iraslav/dsd8-TriSync-DSD/DELIVERABLES_SUMMARY.md

# Timer/Counter Interrupt Add-On — Complete Deliverables Summary

You have been provided with **four comprehensive documents** covering every aspect of the interrupt system implementation.

---

## 📄 Document 1: START_HERE_Interrupt_Addon.md
**Purpose:** Entry point — read this first  
**Length:** ~3 pages  
**What It Contains:**
- High-level overview of what you're building
- Key facts (ports, sources, timeline)
- Three-step project breakdown
- File structure and port map
- Minimal assembly example
- Getting started checklist
- Common questions answered

**When to Read:** First thing — gets you oriented fast

**Key Section:** "Minimal Assembly Example" shows the entire pattern in 15 lines

---

## 📄 Document 2: Timer_Counter_Interrupt_Specification.md
**Purpose:** Complete technical reference  
**Length:** ~50 pages (comprehensive)  
**What It Contains:**
- Detailed hardware architecture (block diagrams)
- Complete register specifications (every bit documented)
- Verilog RTL implementation (~250 lines, ready to use)
- Unit testbench with assertions
- Software interrupt dispatcher in assembly
- Three test programs (with expected behavior)
- Design decisions and justifications
- Integration into dsd8_top.v

**When to Read:** While designing RTL and writing assembly  

**Key Sections:**
- "2. Hardware Architecture" — Block diagram and signals
- "5. Verilog Implementation" — Complete RTL code (copy-paste ready)
- "6. Integration into dsd8_top" — How to add to your design
- "7. Software: Interrupt Dispatcher" — Assembly patterns

---

## 📄 Document 3: Interrupt_Quick_Reference.md
**Purpose:** Quick lookup during implementation  
**Length:** ~6 pages  
**What It Contains:**
- Port map summary (all 16 ports at a glance)
- Register bit layouts (for quick reference)
- Minimal assembly program (complete, working example)
- Implementation checklist (track progress)
- Hardware verification strategy (quick sanity checks)
- Software implementation tips (best practices)
- Common pitfalls and solutions
- Performance expectations
- Testing strategy

**When to Read:** Keep this open while coding  

**Key Sections:**
- "Port Map Summary" — All you need to know about addresses
- "Minimal Assembly Program" — Paste-able, working code
- "Common Pitfalls & Solutions" — Troubleshooting table

---

## 📄 Document 4: Interrupt_Implementation_Roadmap.md
**Purpose:** Week-by-week implementation plan  
**Length:** ~20 pages  
**What It Contains:**
- Detailed breakdown for each week (13, 14, 15, 16)
- Day-by-day tasks with specific deliverables
- Complete code examples for every section
  - RTL module template
  - Dispatcher assembly
  - All test programs
  - Demo program
- Integration instructions (step-by-step)
- Documentation requirements for design report
- Oral defence preparation (talking points)
- Success criteria for each milestone
- Timeline summary and resource list

**When to Read:** At the start of each week  

**Key Sections:**
- "Week 13: RTL Design & Integration" — Complete RTL walkthrough
- "Week 14: Assembly & Verification" — All test programs provided
- "Week 15: Documentation & Demo" — What to document, what to show
- "Week 16: Final Demonstration & Oral Defence" — Defence talking points

---

## 🎯 How to Use These Documents

### Week 13 (RTL Design)

**Read:**
1. START_HERE (overview)
2. Interrupt_Implementation_Roadmap (Week 13 section)
3. Timer_Counter_Interrupt_Specification (Sections 2, 3, 5)

**Use:**
- Interrupt_Quick_Reference (port map)
- Interrupt_Implementation_Roadmap (RTL code examples)

**Create:**
- `interrupt_controller.v` (from spec + roadmap examples)
- `tb_interrupt_controller.v` (unit testbench)

**Verify:**
- Use Interrupt_Quick_Reference checklist

---

### Week 14 (Assembly & Testing)

**Read:**
1. Interrupt_Implementation_Roadmap (Week 14 section)
2. Timer_Counter_Interrupt_Specification (Sections 7, 8)

**Use:**
- START_HERE (dispatcher flow)
- Interrupt_Quick_Reference (port map reference)
- Interrupt_Implementation_Roadmap (assembly code examples)

**Create:**
- `interrupt_dispatcher.asm` (from roadmap)
- `test_interrupt_1.asm` (from roadmap)
- `test_interrupt_2.asm` (from roadmap)
- `test_interrupt_3.asm` (from roadmap)
- `demo_interrupt_blink.asm` (from spec/roadmap)

**Verify:**
- Use Interrupt_Quick_Reference (testing strategy)

---

### Week 15 (Documentation & Demo)

**Read:**
1. Interrupt_Implementation_Roadmap (Week 15 section)

**Reference:**
- Timer_Counter_Interrupt_Specification (design decisions section)
- START_HERE (common questions)

**Create:**
- Design report interrupt section
- System block diagram with interrupt controller
- Verification report with test results

---

### Week 16 (Demo & Defence)

**Read:**
1. Interrupt_Implementation_Roadmap (Week 16 section)

**Prepare:**
- Run demos (test programs from roadmap)
- Practice explanations (talking points in roadmap)

---

## 📋 Document Cross-Reference

### "How do I set up a timer?"
→ START_HERE: "Minimal Assembly Example"  
→ Interrupt_Quick_Reference: "Port Map Summary"  
→ Interrupt_Implementation_Roadmap: "Week 14: Day 1 Test Programs"

### "What are the exact register bit layouts?"
→ Interrupt_Quick_Reference: "Register Bit Layouts"  
→ Timer_Counter_Interrupt_Specification: "Section 3: Register Map"

### "How do I write the RTL?"
→ Interrupt_Implementation_Roadmap: "Week 13: Day 1-2 RTL Design"  
→ Timer_Counter_Interrupt_Specification: "Section 5: Verilog Implementation"

### "What should the dispatcher look like?"
→ START_HERE: "Minimal Assembly Example"  
→ Interrupt_Implementation_Roadmap: "Week 14: Day 1 Interrupt Dispatcher"  
→ Timer_Counter_Interrupt_Specification: "Section 7: Software: Interrupt Dispatcher"

### "What's wrong with my interrupt not firing?"
→ Interrupt_Quick_Reference: "Common Pitfalls & Solutions"  
→ Interrupt_Implementation_Roadmap: "Common Pitfalls & Solutions"

### "What should I explain in my oral defence?"
→ Interrupt_Implementation_Roadmap: "Week 16: Oral Defence Talking Points"  
→ Timer_Counter_Interrupt_Specification: "Section 13: Design Decisions & Justification"

---

## 📊 Document Relationship

```
START_HERE
    ↓ (provides overview)
    → Read first, gets you oriented

Interrupt_Implementation_Roadmap
    ↓ (detailed weekly plan)
    → Use this to track progress through weeks 13-16

Timer_Counter_Interrupt_Specification
    ↓ (comprehensive technical reference)
    → Consult while designing RTL, writing assembly

Interrupt_Quick_Reference
    ↓ (quick lookup)
    → Keep open in separate window while coding
```

---

## 🎓 Learning Outcomes

By following these documents you will:

✅ **Understand interrupt architectures** — Both hardware and software sides  
✅ **Build a real interrupt controller** — From register specifications to RTL  
✅ **Write interrupt handlers** — Assembly patterns that dispatch correctly  
✅ **Verify timing circuits** — Unit tests, integration tests, visual demo  
✅ **Document hardware design** — Professional design decisions and justifications  
✅ **Present technical work** — Confident oral defence with talking points prepared  

---

## ⏱️ Time Investment

| Document | Read Time | Reference Time |
|---|---|---|
| START_HERE | 15 min | — |
| Timer_Counter_Interrupt_Specification | 60 min | Ongoing |
| Interrupt_Quick_Reference | 10 min | Constant |
| Interrupt_Implementation_Roadmap | 30 min | Weekly |
| **Total** | **115 min** | **As needed** |

---

## 📝 Quick Navigation

**I need to understand what I'm building:**  
→ START_HERE

**I need to design the RTL:**  
→ Interrupt_Implementation_Roadmap (Week 13)  
→ Timer_Counter_Interrupt_Specification (Sections 2, 5)

**I need to write the dispatcher:**  
→ Interrupt_Implementation_Roadmap (Week 14, Day 1)  
→ START_HERE (Minimal Assembly Example)

**I forgot what port 0x58 does:**  
→ Interrupt_Quick_Reference (Port Map Summary)

**I'm troubleshooting a bug:**  
→ Interrupt_Quick_Reference (Common Pitfalls)

**I need to write the design report section:**  
→ Interrupt_Implementation_Roadmap (Week 15)  
→ Timer_Counter_Interrupt_Specification (Section 13)

**I need to prepare for the oral defence:**  
→ Interrupt_Implementation_Roadmap (Week 16, Oral Defence Talking Points)

---

## ✅ Document Checklist

Before you start:
- [ ] I have all four documents
- [ ] I understand what each document contains
- [ ] I know which document to consult for which task
- [ ] I've read START_HERE completely
- [ ] I have printed out or bookmarked Interrupt_Quick_Reference

---

## 🚀 You're Ready

Everything you need to build this interrupt system is in these four documents. They are:

1. **Self-contained** — Each document works independently
2. **Cross-referenced** — Links between them guide you to related info
3. **Progressive** — Start with START_HERE, move to detailed specs as needed
4. **Code-complete** — Full RTL, assembly, testbenches provided as examples

**Start with START_HERE. Then follow Interrupt_Implementation_Roadmap week by week. Keep Interrupt_Quick_Reference open always. Reference Timer_Counter_Interrupt_Specification when you need deep technical details.**

---

## 📞 Troubleshooting Guide

**"I'm confused where to start"**  
→ Read START_HERE cover to cover (15 min)

**"I need the exact RTL code"**  
→ Go to Timer_Counter_Interrupt_Specification, Section 5

**"I need a working assembly example"**  
→ Go to Interrupt_Implementation_Roadmap, Week 14, Day 1

**"My simulation isn't working"**  
→ Use Interrupt_Quick_Reference, "Common Pitfalls & Solutions"

**"I need to document this for the design report"**  
→ Go to Interrupt_Implementation_Roadmap, Week 15

**"I need to explain this in my oral defence"**  
→ Go to Interrupt_Implementation_Roadmap, Week 16, "Oral Defence Talking Points"

---

## Final Note

These documents represent **complete specification and implementation guidance** for the Timer/Counter Interrupt system. Everything — from the first RTL line to the final oral defence — is covered.

**You have a professional-quality specification for a real hardware system.**

Follow the roadmap. Execute week by week. Reference the documents as needed. You'll build something impressive.

**Good luck!** 🎯
