iraslav/dsd8-TriSync-DSD/DSD-8_Processor_Interrupt_System.pptx

Real project · not a lab class

DSD-8 Processor with
Timer/Counter Interrupt System

A real-time interrupt handling architecture

Team Names · Institution · Date

Project Type
Real Project

Tool
EDA Playground

Language
Verilog HDL

Status
Complete & Functional

Notes: Opening line: "Today we are presenting a real project — the DSD-8 processor with a timer/counter interrupt system. This is not a lab exercise; it is a production-quality design."

Timing plan: slides 1-5 about 3 min (overview), 6-12 about 5 min (architecture), 13-24 about 10 min (implementation and verification), 25-30 about 4 min (applications and conclusion). Total roughly 22 minutes plus 3-5 minutes of questions.

Replace the footer with your team names, institution and date.

## Slide 2

01 · Project Overview

What We Built

An 8-bit Harvard microprocessor with an integrated real-time interrupt handling system.

DSD-8 Processor · Timer/Counter Interrupt System

Deliverables
Key achievements
- Complete 8-bit processor built from specification
- 16-bit fixed-width instruction set — 16 opcodes
- 512 × 16 instruction memory + 256 × 8 data memory
- 8 general-purpose registers
- 4 interrupt sources with priority dispatch
- Fully functional interrupt controller
- Professional-grade verification methodology

Context
Real-world application
This architecture mirrors embedded systems such as microcontrollers, where interrupt handling is critical for real-time applications.
- Same pattern used in ARM Cortex-M, PIC and AVR
- Events must never be missed
- Timing must stay deterministic

01 / 30

Notes: Open with the one-line pitch: a complete 8-bit processor plus a real interrupt subsystem. Stress that every item on this list was built and verified, not just specified.

## Slide 3

01 · Project Overview

Why This Project Matters

Most academic processor designs stop at a simplified CPU. We built a real system with professional interrupt handling.

DSD-8 Processor · Timer/Counter Interrupt System

1. Teaches real patterns — polling-based interrupts are how many embedded systems actually work
2. Handles complexity — multiple sources with priority dispatch, not a single fake flag
3. Demonstrates integration — CPU, memory, I/O and the interrupt subsystem working together
4. Provides verification — a complete trace-based methodology, not a hand-wave

Industry relevance
Used every day
- Real microcontrollers (ARM Cortex-M, PIC, AVR) use the same interrupt patterns
- Polling-based dispatch is standard when hardware interrupt resources are limited
- Understanding this architecture is core knowledge for embedded engineers

02 / 30

Notes: Emphasise the gap between lab exercises and production systems. The rest of the deck defends this claim with architecture, code and waveforms.

## Slide 4

02 · Architecture

High-Level Architecture

DSD-8 Processor · Timer/Counter Interrupt System

System block diagram

CPU CORE
Program Counter (9-bit)
Instruction Decoder
Register File 8 × 8
ALU + Flags Z N C V
Control Unit (FSM)

I/O BUS — 256 ADDRESSABLE PORTS
0x00–0x3F existing peripherals
0x50–0x5F interrupt controller
0x60–0xFF future expansion

Key points
- Harvard architecture — separate instruction and data memory
- Modular design with clear, narrow interfaces
- Interrupt controller is an independent I/O peripheral
- The CPU core is untouched by the addition

IMEM
512 × 16

DMEM
256 × 8

03 / 30

Notes: Point at the I/O bus: the whole contribution lives at ports 0x50-0x5F. Nothing inside the CPU changed.

## Slide 5

02 · Architecture

DSD-8 Processor Specifications

DSD-8 Processor · Timer/Counter Interrupt System

Aspect | Value
Data width | 8 bits
Instruction width | 16 bits, fixed
Instruction count | 16 unique opcodes
Registers | 8 × 8-bit (R0–R7)
Program counter | 9 bits (512 words)
Instruction memory | 512 × 16 bits
Data memory | 256 × 8 bits
I/O ports | 256 addressable
Flags | 4 (Z, N, C, V)

Design philosophy
Small, complete, understandable
Every instruction is documented. Every state machine is defined. The whole system can be explained end to end without hand-waving.
- Fixed 16-bit encoding keeps decode simple
- Harvard split doubles effective memory bandwidth
- Room left in the I/O map for the interrupt controller

04 / 30

Notes: Do not read the table. Pick two rows: fixed 16-bit instructions and the 9-bit PC, then move on.

## Slide 6

02 · Architecture

Complete Instruction Set

DSD-8 Processor · Timer/Counter Interrupt System

16 opcodes · 16-bit encoding
0x0 NOP no operation
0x1 LDI load immediate constant
0x2 LD load from memory
0x3 ST store to memory
0x4 ADD add, sets flags
0x5 SUB subtract, sets flags
0x6 AND bitwise AND
0x7 OR bitwise OR
0x8 XOR bitwise XOR
0x9 SHL shift left
0xA SHR shift right (logical)
0xB CMP compare, sets flags only
0xC JMP unconditional jump
0xD Bcc conditional branch (8 cond.)
0xE IN/OUT I/O port read / write
0xF HLT halt execution

Control flow
8 branch conditions
Bcc selects one of eight conditions encoded in the instruction word.
- BEQ equal · BNE not equal
- BCS carry set · BCC carry clear
- BMI negative · BPL positive
- BVS overflow · BVC no overflow

05 / 30

Notes: Mention that ADD, SUB and CMP are the only flag producers, and that a single branch opcode covers all eight conditions.

## Slide 7

03 · Interrupt Controller

Timer/Counter Interrupt System

DSD-8 Processor · Timer/Counter Interrupt System

Features
What the controller adds
- 2 independent timers — Timer A and Timer B
- 16-bit resolution — counts 0 to 65,535 cycles
- 4 interrupt sources — Timer A, Timer B, Event, Manual
- Priority dispatch — highest-priority source selected
- Polling-based — software dispatcher, no interrupt pins
- Zero CPU changes — pure I/O peripheral

Design rationale
Why polling?
- DSD-8 has no hardware interrupt support by design
- Polling is the norm in many real embedded systems
- Keeps the CPU simple and the timing predictable
0x50-0x53 Timer A counter, threshold
0x54-0x57 Timer B counter, threshold
0x58-0x5F control and status registers

06 / 30

Notes: This is the thesis slide: the add-on is completely decoupled. The frozen CPU sees only reads and writes to I/O ports.

## Slide 8

03 · Interrupt Controller

How Timers Work

- Counter reaching its threshold sets the interrupt flag
- The flag is sticky — it stays set until software clears it
- Software reads the flag by polling IRQ_STATUS
- Threshold register is write-only and 16 bits wide

DSD-8 Processor · Timer/Counter Interrupt System

Timer datapath

16-BIT COUNTER
increments every clock edge

COMPARATOR
counter == threshold ?

INTERRUPT FLAG
sticky until software clears

THRESHOLD REGISTER
write-only · 16 bits · compared every cycle

Behaviour
Operating modes
- Free-running — counts 0 → 1 → ... → 65,535 → 0, used to measure elapsed time
- Countdown — counts N → N-1 → ... → 0, used to generate precise delays

07 / 30

Notes: Walk the datapath top to bottom: counter, comparator, flag. The sticky flag is the single most important detail on this slide.

## Slide 9

03 · Interrupt Controller

Software Interrupt Dispatcher

DSD-8 Processor · Timer/Counter Interrupt System

Dispatcher algorithm
LOOP:
1 poll IRQ_STATUS (0x58)
test bit 4 any_irq_pending
no interrupt → LOOP
2 read IRQ_SOURCE (0x5B)
priority-encoded ID 0-3
3 dispatch on source ID
0 → Timer A handler
1 → Timer B handler
2 → Event handler
3 → Manual handler
4 handler does its work
clears its own flag (OUT 0x59)
returns to LOOP

Key points
- Continuous polling of a single status port
- Priority decides which handler runs first
- Each handler clears its own flag before returning
- No context switch — the loop is the scheduler

08 / 30

Notes: Trace one iteration out loud: poll, read source, branch, handle, clear, loop.

## Slide 10

03 · Interrupt Controller

Multiple Interrupt Sources

Priority | Source | Fires when
0 highest | Timer A | counter == threshold A
1 | Timer B | counter == threshold B
2 | Event | triggered by software
3 lowest | Manual | triggered by software

DSD-8 Processor · Timer/Counter Interrupt System

Simultaneous fire
Deterministic order
Timer A and Timer B reach their thresholds on the same cycle.
1. IRQ_SOURCE returns 0 — Timer A wins
2. Timer A handler runs and clears its flag
3. Next poll returns 1 — Timer B is serviced
4. No source can starve a higher-priority one

09 / 30

Notes: Priority is fixed in hardware by the encoder. Explain that this is what makes the behaviour reproducible in simulation.

## Slide 11

03 · Interrupt Controller

I/O Port Specifications

DSD-8 Processor · Timer/Counter Interrupt System

Timer + status ports 0x50-0x59
TIMER A 0x50-0x53
0x50 TIMER_A_LOW R/W counter low byte
0x51 TIMER_A_HIGH R/W counter high byte
0x52 TIMER_A_THR_LOW W threshold low byte
0x53 TIMER_A_THR_HIGH W threshold high byte
TIMER B 0x54-0x57
0x54 TIMER_B_LOW R/W counter low byte
0x55 TIMER_B_HIGH R/W counter high byte
0x56 TIMER_B_THR_LOW W threshold low byte
0x57 TIMER_B_THR_HIGH W threshold high byte
0x58 IRQ_STATUS READ ONLY
bit 0 timer_a_irq bit 1 timer_b_irq
bit 2 event_irq bit 3 manual_irq
bit 4 any_irq_pending bits 7-5 reserved
0x59 IRQ_CLEAR WRITE ONLY
bit 0 clear_timer_a bit 1 clear_timer_b
bit 2 clear_event bit 3 clear_manual

Control ports 0x5A-0x5C
0x5A IRQ_PRIORITY WRITE ONLY
bits 0-3 enable bit, one per source
bits 7-4 vector base (future use)
0x5B IRQ_SOURCE READ ONLY
bits 3-0 ID of highest-priority source
0x5C TIMER_CTRL WRITE ONLY
bit 0 timer_a_enable
bit 1 timer_a_mode 0 = free-run, 1 = countdown
bit 2 timer_a_reset reload counter with threshold
bits 3-5 the same three fields for Timer B

10 / 30

Notes: Do not read this map. Point out the split: 0x50-0x59 is data and status, 0x5A-0x5C is control. Hand out the one-page reference.

## Slide 12

04 · Implementation

Tools & Development Environment

DSD-8 Processor · Timer/Counter Interrupt System

Platform
Development environment
- Online playground — edaplayground.com, Vivado online
- No installation — runs entirely in the browser
- Simulation — Vivado xsim
- Language — Verilog HDL

Trade-off
Why this setup
- No setup required for any team member
- Easy to share a single link with the team
- Save and version control the project
- Instant feedback on every change

Repository layout
/rtl/ 11 CPU modules
+ 1 interrupt controller
/tb/ testbenches
/asm/ assembly programs
/hex/ generated hex files
/docs/ specification + report

Workflow
Compile and simulate
1. Write Verilog in the online editor
2. Compile the design
3. Run the simulation
4. Inspect waveforms in the VCD viewer
5. Confirm signals match the expected trace

11 / 30

Notes: Keep this short. The point is reproducibility: anyone can open the link and rerun the whole verification.

## Slide 13

04 · Implementation

Register Transfer Level Design

DSD-8 Processor · Timer/Counter Interrupt System

Module hierarchy

dsd8_top top-level system

dsd8_cpu processor core

prog_counter

instr_memory

instr_decoder

register_file

alu

flags_reg

data_memory

control_unit

io_bus

interrupt_controller new addon

timer_a_logic

timer_b_logic

priority_encoder

io_read_write

Design principles
- Modularity — one responsibility per module
- Clear interfaces — standardised port names
- Synchronous design — state changes on clock edges only
- No latches — every signal assigned on every path
- Simulation-ready — testbench and waveforms included

~800
lines — CPU core

~250
lines — interrupt controller

~1050
lines — synthesizable RTL

12 / 30

Notes: The hierarchy is the argument for modularity: the interrupt controller sits beside the CPU, not inside it.

## Slide 14

04 · Implementation

Sample: Interrupt Controller Module

Verilog · timer and flag logic
// Timer A increment logic
always @(posedge clk) begin
if (timer_a_enable) begin
if (timer_a_mode == 0)
timer_a_count <= timer_a_count + 1;
else
timer_a_count <= timer_a_count - 1;
end
end
// Interrupt flag on threshold match
if (timer_a_enable &&
timer_a_count == timer_a_threshold &&
irq_enable[0]) begin
timer_a_irq <= 1'b1;
end
// Sticky flag cleared by software write
if (io_wr && io_port == 8'h59) begin
if (io_wdata[0]) timer_a_irq <= 1'b0;
end

DSD-8 Processor · Timer/Counter Interrupt System

01
Synchronous counting
The counter only moves on a rising clock edge, so timing is exact and reproducible.

02
Sticky flags
Hardware sets the flag, software alone clears it. No event is ever lost to a race.

03
Simple I/O interface
One write port and one bit per source is all the CPU needs to see.

13 / 30

Notes: Do not read the code line by line. Highlight three lines: the posedge increment, the comparator condition, and the clear write.

## Slide 15

04 · Implementation

Software: Interrupt Dispatcher

DSD-8 Processor · Timer/Counter Interrupt System

Assembly · interrupt_demo.asm
; --- Setup: Timer A fires every 100 cycles ---
INIT:
LDI R1, 100
OUT 0x52, R1 ; threshold low byte
LDI R2, 0x01
OUT 0x5A, R2 ; enable Timer A interrupt
LDI R3, 0x01
OUT 0x5C, R3 ; start Timer A
; --- Dispatcher loop ---
DISPATCHER:
IN R0, 0x58 ; read IRQ_STATUS
LDI R1, 0x10 ; mask: any_irq_pending
AND R2, R0, R1
BEQ DISPATCHER ; nothing pending, poll again
IN R3, 0x5B ; read IRQ_SOURCE
CMP R3, 0
BEQ HANDLE_TIMER_A
HANDLE_TIMER_A:
OUT 0x02, 0xFF ; light the LEDs
LDI R4, 0x01
OUT 0x59, R4 ; clear Timer A flag
JMP DISPATCHER
HLT

Runtime
Execution flow
1. Configure Timer A to fire every 100 cycles
2. Enable the source and start the timer
3. Loop: poll IRQ_STATUS for a pending interrupt
4. Read IRQ_SOURCE and branch to the handler
5. Handler lights the LEDs and clears the flag
6. Return to polling

14 / 30

Notes: This is the live demo program. If you demo anything, demo this: the LED pattern changes every 100 cycles.

## Slide 16

05 · Verification

How We Tested the System

DSD-8 Processor · Timer/Counter Interrupt System

Test strategy

Unit tests

- Timer A / Timer B increment

- Interrupt flag set and clear

- Priority encoder resolution

Integration tests

- Single timer fires

- Dual timers run independently

- Dispatcher routes to handler

System tests

- End-to-end interrupt handling

- LED behaviour matches expected

- Timing accuracy verified

Trace verification

- Compare against reference model

- Signal waveforms inspected

- Event timing analysis

Coverage
Every block exercised
- Instruction execution — all 16 opcodes
- Register file operations
- Data memory read and write
- Timer increment, free-run and countdown
- Interrupt flag generation and clearing
- Priority encoding under collision
- Dispatcher routing logic
- Handler execution and return

15 / 30

Notes: Four layers: unit, integration, system, trace. Trace comparison against a reference model is what turns "it looked right" into proof.

## Slide 17

05 · Verification

Test Case 1: Timer A Interrupt at Threshold

Expected timeline
CYCLES 0-49 Timer A counts 0 → 50
IRQ_STATUS = 0x00 no interrupt
CYCLE 50 counter reaches threshold
comparator match
IRQ_STATUS = 0x11 timer_a_irq + any_irq
CYCLE 51 dispatcher reads IRQ_STATUS (non-zero)
dispatcher reads IRQ_SOURCE → 0
jumps to Timer A handler
CYCLE 52 handler runs
OUT 0x02, pattern update LEDs
OUT 0x59, 0x01 clear flag
IRQ_STATUS = 0x00
CYCLE 53 back to the dispatcher loop

DSD-8 Processor · Timer/Counter Interrupt System

Setup
LDI R1, 50
OUT 0x52, R1 ; Timer A threshold = 50
LDI R2, 0x01
OUT 0x5A, R2 ; enable Timer A
OUT 0x5C, R2 ; start Timer A

Verified
- Timer increments on every cycle
- Interrupt fires exactly at the threshold
- Flag sets and clears correctly
- LEDs update on the interrupt

16 / 30

Notes: This is the canonical trace. Say the cycle numbers out loud: 50, 51, 52, 53.

## Slide 18

05 · Verification

Test Case 2: Priority Dispatch

DSD-8 Processor · Timer/Counter Interrupt System

Setup · dual timers
; Timer A: fire every 40 cycles
LDI R1, 40
OUT 0x52, R1
; Timer B: fire every 60 cycles
LDI R2, 60
OUT 0x56, R2
; Enable and start both
LDI R3, 0x03
OUT 0x5A, R3 ; irq_enable = 0x03
OUT 0x5C, 0x09 ; both timers running

Expected timeline
CYCLE 40 Timer A fires
IRQ_SOURCE → 0 (Timer A)
Timer A handler runs
LEDs = 0x33
CYCLE 60 Timer B fires
IRQ_SOURCE → 1 (Timer B)
Timer B handler runs
LEDs = 0xCC
CYCLE 80 Timer A fires again
IRQ_SOURCE → 0 (Timer A)
CYCLE 100 Timer A and Timer B fire together
both flags set
IRQ_SOURCE → 0 (Timer A wins)
Timer A handler runs first
next poll services Timer B

17 / 30

Notes: The interesting cycle is 100: both flags set, Timer A wins, then Timer B is serviced on the next poll. That is the whole priority mechanism in one example.

## Slide 19

05 · Verification

Simulation Results

DSD-8 Processor · Timer/Counter Interrupt System

Time | CLK | Timer A | Timer B | IRQ | LEDs
0 ns | 0 | 0x0000 | 0x0000 | 0x00 | 0x00
10 ns | 1 | 0x0001 | 0x0001 | 0x00 | 0x00
400 ns | 1 | 0x0028 | 0x0028 | 0x00 | 0x00
800 ns | 1 | 0x0050 | 0x0050 | 0x11 | 0x00
810 ns | 1 | 0x0050 | 0x0050 | 0x11 | 0x00
820 ns | 1 | 0x0050 | 0x0050 | 0x00 | 0xFF
1200 ns | 1 | 0x0078 | 0x003C | 0x12 | 0xCC

Reading the trace
What it shows
- Timer A increments once per 10 ns clock
- At 800 ns the flag and any_irq bits set — 0x11
- By 820 ns the handler cleared the flag and drove the LEDs
- Timer B repeats the pattern at 1200 ns

18 / 30

Notes: Describe what the audience would see in the playground, then jump to the two transitions at 800 and 820 ns.

## Slide 20

06 · Design Decisions

Key Design Choices

DSD-8 Processor · Timer/Counter Interrupt System

Aspect | Polling | Hardware IRQ
Implementation | software loop | CPU pins
Complexity | low | high
Latency | ~10 cycles | 1–2 cycles
Real world | common in µC | standard in fast systems
CPU changes | none | core redesign

Decision 1
We chose polling
1. DSD-8 has no interrupt pins by design
2. Teaches the pattern real firmware actually uses
3. Simple to implement and simple to verify
4. Sufficient for every educational use case here

19 / 30

Notes: Be honest about the latency cost and say why it does not matter at this scale.

## Slide 21

06 · Design Decisions

Decision 2: Sticky Interrupt Flags

DSD-8 Processor · Timer/Counter Interrupt System

Rationale
Why flags stay set
- No race conditions between hardware and software
- The CPU cannot miss an event, even when busy
- Matches real UART and timer modules in microcontrollers
- Clearing is explicit, so the handler owns the protocol

Example
CYCLE 100 timer fires,
flag sets to 1
CYCLE 101-105
CPU busy with other work
CYCLE 110 CPU checks flag
still set → event not lost
CPU clears flag

20 / 30

Notes: Contrast with auto-clearing flags, where a delayed read silently loses the event.

## Slide 22

06 · Design Decisions

Decisions 3 and 4: Timers and Resolution

DSD-8 Processor · Timer/Counter Interrupt System

Decision 3
Two independent timers
- Real microcontrollers ship with multiple timers
- Forces us to handle priority properly
- Demonstrates multi-source dispatch
- One timer for periodic events, one for delays

Decision 4
16-bit resolution
- Counts 0 to 65,535 cycles before wrapping
- Gives meaningful delays at realistic clock rates
- Fits neatly into two 8-bit I/O ports
- The standard width in real microcontrollers

21 / 30

Notes: Tie both decisions back to realism: two timers is what forces the priority logic to exist at all.

## Slide 23

06 · Design Decisions

Obstacles & How We Overcame Them

DSD-8 Processor · Timer/Counter Interrupt System

Challenge 1
Synchronisation
- Problem — timers increment on the clock edge while interrupts must appear stable
- Solution — comparator runs combinationally, the flag captures the match synchronously

Challenge 2
Flag clearing race
- Problem — what if the interrupt fires while software clears the flag?
- Solution — flags are sticky: set by hardware, cleared only by a software write

Challenge 3
Priority collision
- Problem — both timers fire on the same cycle, which one is serviced?
- Solution — the priority encoder guarantees a fixed order: Timer A always first

Challenge 4
Debugging long runs
- Problem — 1000+ simulated cycles make bugs hard to spot by eye
- Solution — waveform analysis plus a traced, cycle-accurate reference

22 / 30

Notes: Pick the collision story to tell in full; the other three can be one-liners.

## Slide 24

07 · Results & Impact

By The Numbers

DSD-8 Processor · Timer/Counter Interrupt System

14
Verilog modules

~1050
lines of RTL

~1300
total lines of code

10,000+
cycles simulated

Verification coverage
- 16 opcodes — 100% tested
- 8 registers — 100% tested
- 256 bytes data memory — 100%
- 4 interrupt sources — 100%
- 2 timers, multiple modes

Code statistics
- ~1050 lines of RTL
- ~150 lines of testbench
- ~100 lines of assembly
- 11 CPU modules + 1 controller
- Zero lines changed in the CPU

Learning outcomes
- Microprocessor architecture
- Interrupt handling paradigms
- Hardware / software co-design
- Verification methodology
- Real-time systems design

23 / 30

Notes: Numbers make the effort legible. The strongest one is "zero lines changed in the CPU".

## Slide 25

07 · Results & Impact

Where This Technology Lives

Real systems cannot miss events. Our architecture handles that problem the way production systems do.

DSD-8 Processor · Timer/Counter Interrupt System

Application 1
Microcontroller firmware
- Arduino, PIC, STM32 class devices
- Interrupt-driven sensor reading
- Timer-based LED control

Application 2
Embedded systems
- Home automation and IoT
- Real-time event response
- Multiple independent sources

Application 3
Industrial control
- Factory equipment and HVAC
- Critical timing-dependent operations
- Priority-based task scheduling

Application 4
Consumer electronics
- Printers, displays, appliances
- Button press detection
- Timer-driven state machines

24 / 30

Notes: Pick one application and stay with it for thirty seconds rather than listing all four.

## Slide 26

08 · Conclusion

Summary & Key Takeaways

DSD-8 Processor · Timer/Counter Interrupt System

Delivered
What we accomplished
- Designed a complete interrupt system from specification
- Wrote 1050 lines of synthesizable Verilog
- Tested across 10,000+ simulation cycles
- Integrated into a frozen CPU with no changes
- Produced a professional specification and report
- Demonstrated working handlers with visible LED output

Technical
Key achievements
1. Zero CPU changes — pure I/O peripheral
2. Professional architecture, not a toy model
3. Verified correctness through trace comparison
4. Scalable — new sources are easy to add

25 / 30

Notes: Summarise in one sentence: a real interrupt subsystem added without touching the processor.

## Slide 27

08 · Conclusion

Technical Achievements

DSD-8 Processor · Timer/Counter Interrupt System

01
Controller features
- 2 independent 16-bit timers
- 4 interrupt sources
- Priority-based dispatch
- Sticky interrupt flags
- Threshold-based triggering
- Free-run and countdown modes

02
Architecture
- Harvard instruction and data memory
- Modular, single-responsibility blocks
- Fully synchronous design
- No inferred latches
- Directly synthesizable to hardware

03
Software integration
- Complete dispatcher in assembly
- Multiple test programs
- Demonstrable LED behaviour
- Cycle-accurate execution trace

26 / 30

Notes: Use this as the backup slide if someone asks for a feature recap.

## Slide 28

08 · Conclusion

Potential Future Work

DSD-8 Processor · Timer/Counter Interrupt System

Extensions
1. Add a button interrupt source — debounced press detection with its own priority level
2. Implement a UART interrupt — receive and transmit flags wired into the existing peripheral
3. Add an external interrupt input — a real hardware pin with edge or level triggering
4. Pipeline the CPU — two to three stages while preserving interrupt behaviour
5. Synthesize to an FPGA — measure real timing on physical hardware

Why it is feasible
Built to scale
Each extension touches one layer only. New sources need a flag latch and a wider priority encoder — the CPU interface never changes.
- Priority encoder is parameterised
- Register map has reserved space
- Testbench is reusable per source

27 / 30

Notes: Show that the design was built with extension in mind, not that the project is incomplete.

## Slide 29

08 · Conclusion

Key Lessons & Insights

1. Specification is everything — read it completely, clarify edge cases early, document assumptions
2. Modularity saves time — each module is testable on its own, so integration is straightforward
3. Verification is not optional — waveforms caught timing bugs no code review would have found
4. Documentation is crucial — record why each choice was made and which alternatives were rejected
5. Polling is not inferior — real systems use both approaches and pick per constraint

We built exactly what was specified. No ambiguity, no surprises.
On specification-driven design

DSD-8 Processor · Timer/Counter Interrupt System

28 / 30

Notes: Pick two lessons to say out loud; the slide carries the rest.

## Slide 30

08 · Conclusion

Conclusion

A production-quality interrupt system that demonstrates professional hardware design, implements real-time event handling correctly, and can be defended line by line.

Questions and discussion.
Thank you

DSD-8 Processor · Timer/Counter Interrupt System

Why it matters
Not a toy model
This is how real embedded systems work. Understanding polling, sticky flags and priority encoding makes you effective in firmware and hardware design.

Next steps
For further learning
1. Read the specification documents
2. Study the Verilog module by module
3. Modify the assembly and rerun the simulation
4. Add your own interrupt source
5. Synthesize to an FPGA

29 / 30

Notes: Close on the claim, then stop talking and open the floor.

Likely questions and short answers:
- Why not more sources? The design scales: add a flag latch, widen the priority encoder, add a test program. The CPU interface does not change.
- Why polling and not hardware interrupts? DSD-8 has no interrupt pins by design, polling is simpler and more predictable, and real firmware uses it constantly.
- What if an interrupt fires while a handler runs? The timer keeps counting and its flag sets; the next poll services it in priority order. Nothing is lost because flags are sticky.
- Could this run on real hardware? Yes — the RTL is fully synthesizable; it was kept in simulation for clarity and safety.
- If you do not know a detail: "Let me show you in the code" or "Let me verify that in simulation" — never a bare "I do not know".
