iraslav/dsd8-TriSync-DSD/DSD8_Architecture_and_Toolchain_Guide.pptx

## DSD-8: How the Modules Fit Together

Block diagrams, the retire_ trace interface, the Python assembler, and how to write test programs that prove the processor works

PC

DEC

RF

ALU

FLAGS

DMEM

CTRL

IO

Digital System Design · DSD-8 processor project · class guide

Notes: This deck is a companion to the DSD-8 specification and the starter repository. It explains how the eleven RTL files connect, what every port (handle) is for, how the retire_ outputs turn your processor into something that can be graded automatically, how the Python assembler turns your assembly into a hex image, and how to write test programs systematically. Nothing here replaces the spec; where the spec and this deck disagree, the spec wins.

## What this guide covers

The architecture at a glance

numbers, hierarchy, files, instruction formats

1

slides 3–8

Module by module

every port (handle), where it connects, the rule that bites

2

slides 9–18

Wiring it together

system view, datapath, glue logic, control, branch, I/O, reset

3

slides 19–28

The retire_ interface

what retiring means, the ten trace outputs, timing, debugging

4

The Python assembler

language rules, two passes, encoders, .asm → .hex

5

Writing test programs

layers, rules, worked tests, random programs, bring-up order

6

slides 29–39

slides 40–47

slides 48–57

Notes: Parts 1 to 3 are the hardware: what exists and how it is wired. Part 4 is the bridge between your hardware and the grader. Parts 5 and 6 are the software side: how you produce programs and how you use them to find bugs.

## The architecture at a glance

Part 1

What DSD-8 is, how the files are organised, and the instruction formats every module is built around

1

Notes: Part 1: The architecture at a glance. What DSD-8 is, how the files are organised, and the instruction formats every module is built around.

## DSD-8 in eight numbers

8-bit

datapath

every register, ALU operand and memory byte is 8 bits

8

registers R0–R7

none hard-wired; R0 is an ordinary register

16

opcodes, 5 formats

16-bit instruction word, opcode always in [15:12]

512 × 16

instruction memory

9-bit PC, absolute branch targets 0x000–0x1FF

256 × 8

data memory

address comes from a register: LD rd,[rs1]

256

I/O ports

separate port space via IN / OUT with a ready handshake

4

flags Z N C V

set only by ADD SUB AND OR XOR SHL SHR CMP

1

trace line per instruction

emitted from retire_* — this is how you are graded

Notes: Keep these numbers in your head; they explain every port width you will see. 9 bits of PC because 512 instruction words. 8 bits of data address because 256 bytes. 3 bits of register address because 8 registers. 4 bits of opcode because 16 instructions. The last tile is the one this deck spends the most time on.

## Module hierarchy: board build and simulation build

On the FPGA board

In simulation (conformance grading)

dsd8_top

tb_dsd8
supplied harness

instr_memory
512×16 ROM

dsd8_cpu
the core

io_bus
ports + ready

instr_memory
#(IMAGE="Txx.hex")

dsd8_cpu
YOUR design

I/O side
io_bus + sim/peripherals.v

ownership

prog_counter

board pins
switches, buttons, leds, seg / an

retire_*

member A: fetch, decode

member B: regs, ALU

instr_decoder

trace writer
always @(posedge clk)
if (rst_n && retire) $fdisplay

member C: ctrl, mem, I/O

register_file

alu

shared

flags_reg

dut.trace

data_memory

Same core, two homes
tb_dsd8 instantiates dsd8_cpu directly. dsd8_top is only for the board demo, so a bug in dsd8_top can never cost conformance marks — and a port renamed in dsd8_cpu breaks the harness.

control_unit

Notes: Two trees, one core. On the left is the board build: dsd8_top wraps the core, the instruction ROM, the I/O bus and the board pins. On the right is the grading build: the supplied harness tb_dsd8 instantiates dsd8_cpu directly with an instruction memory loaded from one test's hex file, and writes a trace line whenever retire is high. instr_memory and io_bus are deliberately outside dsd8_cpu, so the core can be dropped into either home. Colours show module ownership from the starter repo comments: A owns PC, decoder and instruction memory; B owns register file, ALU and flags; C owns control unit, data memory and I/O bus. dsd8_cpu and dsd8_top are shared.

## The eleven RTL files

File | Owner | Kind | What it does | Spec
prog_counter.v | A | sequential | 9-bit PC: hold, increment (wraps) or load a branch target | §5.3
instr_memory.v | A | ROM, comb. read | 512 × 16 program store, filled from a .hex by $readmemh | §5.4
instr_decoder.v | A | combinational | slices the 16-bit word into opcode, register, immediate, address fields | §5.5
register_file.v | B | seq. write, comb. read | 8 × 8 registers, two read ports, one write port, all clear on reset | §5.6
alu.v | B | combinational | ADD SUB AND OR XOR SHL SHR CMP plus the Z N C V outputs | §5.7, §2.3
flags_reg.v | B | sequential | the architectural Z N C V, written only by flag-setting instructions | §5.8
data_memory.v | C | seq. write, comb. read | 256 × 8 RAM; no reset port, yet must read 0x00 before first write | §5.9
control_unit.v | C | FSM | sequences each instruction; drives every enable, select and retire | §6
io_bus.v | C | decode + handshake | port decode, LEDs / 7-seg registers, io_ready stall | §7
dsd8_cpu.v | shared | structural + glue | instantiates the seven core modules, muxes, retire_* outputs | §5.2
dsd8_top.v | shared | structural | board top: core + instruction ROM + I/O bus + pins | §5.1

Every port list is FROZEN: copy names and widths verbatim. Internals are yours.

Notes: Three kinds of file. Purely combinational modules (decoder, ALU) have no clock and recompute all the time. Sequential modules (PC, flags) change only at a rising clock edge and only when enabled. Memories mix the two: the write waits for an edge, the read is combinational. The two shared files are where integration happens, and dsd8_cpu is more than wires: it also holds the write-back multiplexer and a few gates of glue, which we look at in Part 3.

## Five instruction formats, one fixed field layout

R

ADD SUB AND OR XOR SHL SHR CMP

15

opcode

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
opcode

rd

0

imm8

M

LD ST

opcode

rd / data

rs1 = addr

000000

J

JMP Bcc

opcode

cond

addr9

P

IN OUT

opcode

rd / rs

dir

port

decoder outputs (always all of them):

opcode [15:12]

rd = cond [11:9]

rs1 [8:6]

rs2 [5:3]

io_dir [8]

addr9 [8:0]

imm8 = port [7:0]

Notes: Every format puts the opcode in bits 15 to 12, so decoding always starts the same way. The fields overlap on purpose: rd and cond are the same three bits, imm8 and port are the same eight bits, rs1 is the top of addr9. The decoder extracts every field from every word without looking at the opcode; the control unit decides which fields mean something. Two operand traps live here: in Format M the data register for ST sits in the rd position (bits 11:9), and in Format P the register for OUT also sits there. Reserved bits are written as zero by the assembler.

## Opcode map: what each instruction changes

Op | Instruction | Fmt | Operation | Reg write | DMEM write | Flags | Next PC
0 | NOP | – | nothing (0x0000) | – | – | – | PC+1
1 | LDI rd, imm8 | I | R[rd] ← imm8 | yes | – | – | PC+1
2 | LD rd, [rs1] | M | R[rd] ← DMEM[R[rs1]] | yes | – | – | PC+1
3 | ST [rs1], rs2 | M | DMEM[R[rs1]] ← R[rs2] (rs2 in bits 11:9) | – | yes | – | PC+1
4 | ADD rd, rs1, rs2 | R | R[rd] ← R[rs1] + R[rs2] | yes | – | Z N C V | PC+1
5 | SUB rd, rs1, rs2 | R | R[rd] ← R[rs1] − R[rs2] (C=1: no borrow) | yes | – | Z N C V | PC+1
6–8 | AND / OR / XOR | R | R[rd] ← R[rs1] op R[rs2] | yes | – | Z N, C=V=0 | PC+1
9 | SHL rd, rs1 | R | R[rd] ← R[rs1] << 1 | yes | – | Z N, C=b7, V=0 | PC+1
A | SHR rd, rs1 | R | R[rd] ← R[rs1] >> 1 (logical) | yes | – | Z N, C=b0, V=0 | PC+1
B | CMP rs1, rs2 | R | flags of R[rs1] − R[rs2], no register written | – | – | Z N C V | PC+1
C | JMP addr9 | J | PC ← addr9 | – | – | – | addr9
D | Bcc addr9 | J | if cond(flags): PC ← addr9 | – | – | – | addr9 / PC+1
E | IN rd, port | P | R[rd] ← io_rdata (dir = 0) | yes | – | – | PC+1
E | OUT port, rs | P | io_wdata ← R[rs] (dir = 1) | – | – | – | PC+1
F | HLT | – | stop; assert halted | – | – | – | holds

Notes: This table is the contract between the ISA and your control unit. Read it column by column: the Reg write column is exactly where rf_we must be 1, DMEM write is mem_we, Flags is flags_we. Two rows deserve a second look: CMP sets flags but writes no register, and ST takes its data from the register named in bits 11:9. Opcode 0xE is shared by IN and OUT; bit 8 (dir) tells them apart.

## Module by module

Part 2

Every port is a handle: who drives it, who listens, and the one rule that catches people

2

Notes: Part 2: Module by module. Every port is a handle: who drives it, who listens, and the one rule that catches people.

## prog_counter: where the next instruction comes from

Handle | Dir | Bits | Connects to | Purpose
clk, rst_n | in | 1 | system | sync. active-low reset: pc ← 0x000
pc_en | in | 1 | control_unit.pc_en | 1 = update PC at this edge; 0 = hold
pc_load | in | 1 | control_unit.pc_load | 1 = branch_addr; 0 = pc + 1 (wraps)
branch_addr | in | 9 | instr_decoder.addr9 | absolute JMP / Bcc target
pc | out | 9 | imem_addr, retire_pc | address of the executing instruction

prog_counter

sequential · 9-bit register

rst_n

pc_en

pc_load

branch_addr

clk

pc

9

9

always @(posedge clk)
if (!rst_n) pc <= 9'h000;
else if (pc_en) pc <= pc_load ? branch_addr
: pc + 9'd1;
// else: hold

What the frozen ports imply
There is no IR-load signal. Simplest scheme: keep PC on the current instruction for all of its cycles and pulse pc_en once, in its last cycle. Then imem_data is your instruction register and pc is retire_pc.

Classic bug
First instruction executed twice or skipped: check what pc_en does in the cycle reset is released.

Notes: The PC is the only state that decides which instruction runs. Its rule fits in four lines, shown in the code box; it is spec requirement R6–R7, not a design secret. The interesting part is the consequence of the frozen port lists: control_unit has no output to load an instruction register, so the cleanest design leaves the PC pointing at the executing instruction until the instruction finishes. The instruction memory read is combinational, so imem_data then stays valid for the whole instruction. If your team instead advances the PC early, you need your own IR and a copy of the old PC inside dsd8_cpu, both for decoding and for retire_pc.

## instr_memory: the program, loaded from a hex file

Handle | Dir | Bits | Connects to | Purpose
IMAGE | param | – | tb_dsd8 / dsd8_top | hex file read by $readmemh at time 0
clk | in | 1 | system | unused: the read is combinational
addr | in | 9 | imem_addr (= pc) | word address 0x000–0x1FF
data | out | 16 | imem_data | instruction word → decoder, retire_ir

instr_memory

512 × 16 ROM · #(IMAGE)

addr

9

clk

data

16

// T05.hex
// one word per line
0000
0000
F000

reg [15:0] mem [0:511];
initial $readmemh(IMAGE, mem);
assign data = mem[addr];

Words past the end of the image are X
$readmemh writes only as many words as the file holds; this module does not zero-fill the rest. A program that runs past its last line fetches X and the whole core goes X. End every program with HLT and keep branch targets inside it.

Notes: The instruction memory is read-only and outside dsd8_cpu. The harness instantiates it once per test with a different IMAGE parameter, which is why the hex file name never appears inside your core. The supplied module reads combinationally, so the word for address pc is available in the same cycle. Section 5.4 allows a registered read too, but then your control unit must budget the extra cycle. Note the X hazard: unlike data memory, nothing initialises the unused words.

## instr_decoder: slicing the word, never interpreting it

Output | Field | Width | Connects to | Purpose
opcode | [15:12] | 4 | control_unit, alu.op, glue | selects the instruction
rd | [11:9] | 3 | register_file.wa, ra2 mux | destination; ST / OUT data reg
rs1 | [8:6] | 3 | register_file.ra1 | first source; LD / ST address
rs2 | [5:3] | 3 | ra2 mux | second source (R format)
imm8 | [7:0] | 8 | write-back mux, input 2 | LDI constant
addr9 | [8:0] | 9 | prog_counter.branch_addr | JMP / Bcc target
cond | [11:9] | 3 | control_unit.cond | branch condition
port | [7:0] | 8 | dsd8_cpu.io_port | I/O port number
io_dir | [8] | 1 | IN/OUT glue in dsd8_cpu | 0 = IN, 1 = OUT

instr_decoder

combinational

rd

rs1

rs2

imm8

addr9

cond

port

io_dir

16

instr

opcode

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
This module never looks at opcode
Nine plain bit slices, no case statement. Overlaps are deliberate: rd = cond, imm8 = port, rs1 sits inside addr9. Choosing which field matters is the control unit's job.

Bit positions: spec Appendix A, and the comments in the stub itself.

Notes: The decoder is the simplest module in the design and the one whose bugs are most expensive, because a wrong slice looks like an execution bug. Check it against the worked encoding table in the spec (11 encodings) before running anything. Every handle except instr is an output, so the table lists bit positions instead of a direction. Notice where each field goes: rd goes to two places (write address and the ra2 multiplexer) because of the ST and OUT operand order.

## register_file: two reads, one write, eight registers

Handle | Dir | Bits | Connects to | Purpose
ra1 | in | 3 | decoder.rs1 | selects rd1
ra2 | in | 3 | ra2 mux: rs2, or rd for ST / OUT | selects rd2
rd1 | out | 8 | alu.a, data_memory.addr | R[ra1], combinational
rd2 | out | 8 | alu.b, dmem wdata, io_wdata | R[ra2], combinational
we | in | 1 | control_unit.rf_we (qualified) | write at this edge
wa | in | 3 | decoder.rd | register written
wd | in | 8 | write-back mux output | value written

register_file

seq. write · comb. read

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
rst_n

rd2

3

3

8

R14: same-cycle read returns the OLD value
A write and a read of the same register in one cycle: the read ports show the old contents; the new value appears from the next cycle. Do not add write-through forwarding — the reference does not have it.

Why ra2 needs a mux
ST [rs1], rs2 and OUT port, rs keep their data register in bits 11:9 (the rd field). So port 2 reads rs2 for R-format, rd for ST and OUT.

Notes: Two read ports so that an R-format instruction can read both operands in one cycle. rd1 always carries R[rs1], which is both the ALU's first operand and the data-memory address. rd2 carries the second operand, which for ST and OUT must be the register in the rd field: that is the reason for the small multiplexer on ra2, which lives in dsd8_cpu. Reset clears all eight registers; R0 is not special.

## alu: results and flags, from the opcode directly

Handle | Dir | Bits | Connects to | Purpose
a | in | 8 | register_file.rd1 | R[rs1]
b | in | 8 | register_file.rd2 | R[rs2]
op | in | 4 | decoder.opcode | 0x4 ADD … 0xB CMP (R15)
result | out | 8 | write-back mux, input 0 | the 8-bit result
flag_z…v | out | 1 | flags_reg.flags_in, retire | {Z,N,C,V} after the op

alu

combinational

flag_c

flag_v

8

8

a

result

8

4

b

op

flag_z

flag_n

Op | Z | N | C | V
ADD | result = 0 | result[7] | carry out of bit 7 | signed overflow
SUB, CMP | result = 0 | result[7] | 1 = no borrow (a ≥ b unsigned) | signed overflow
AND OR XOR | result = 0 | result[7] | 0 | 0
SHL | result = 0 | result[7] | old a[7] | 0
SHR (logical) | result = 0 | result[7] | old a[0] | 0

The bug this design reliably produces
C after SUB / CMP means NO borrow (compute a + ~b + 1 and take the carry). BCS = unsigned ≥. SHR shifts a 0 into bit 7: 0x80 >> 1 = 0x40.

Notes: The ALU takes the instruction opcode directly as its operation select, so there is no separate ALU-control encoding. CMP computes exactly what SUB computes; the difference is that the control unit does not write the result. The flag table is the whole truth: copy it into your testbench's reference model independently, and the spec requires a constrained-random self-checking testbench for this module. For opcodes that are not ALU operations, the outputs are don't-care, but give the case statement a default so nothing is inferred as a latch.

## flags_reg: architectural state with a narrow write enable

Handle | Dir | Bits | Connects to | Purpose
flags_we | in | 1 | control_unit.flags_we | 1 only for the 8 flag-setting instructions
flags_in | in | 4 | {flag_z, flag_n, flag_c, flag_v} | new flags from the ALU
flags_out | out | 4 | control_unit.flags, retire_flags | {Z,N,C,V}: bit 3 = Z … bit 0 = V

flags_reg

sequential · 4-bit register

rst_n

flags_we

flags_in

clk

flags_out

4

4

Z

bit 3

N

bit 2

C

bit 1

V

bit 0

Same order everywhere: flags_in, flags_out, control_unit.flags, retire_flags, and trace field 10.

Reset
Z = N = C = V = 0 after reset (R6). The stub already does this; you add only the flags_we write.

LD, LDI, IN do NOT set flags
Only ADD SUB AND OR XOR SHL SHR CMP write the flags. Branching on a value you just loaded needs a CMP first — a deliberate decision in the spec.

Notes: flags_reg is four flip-flops, but it is architectural state: programs see it through branches and the grader sees it in every trace line. The write enable must be exactly the eight flag-setting instructions. A common integration bug is to write the flags on every ALU-looking cycle, including LD, which corrupts a CMP result that a later branch depends on.

## data_memory: 256 bytes that must start at zero

Handle | Dir | Bits | Connects to | Purpose
addr | in | 8 | register_file.rd1 (R[rs1]) | byte address for LD and ST
we | in | 1 | control_unit.mem_we | write wdata at this edge (ST only)
wdata | in | 8 | register_file.rd2 (R[rd]) | byte to store
rdata | out | 8 | write-back mux, input 1 | mem[addr], combinational, for LD

data_memory

seq. write · comb. read

addr

we

wdata

8

clk

rdata

8

8

No rst_n port — yet R16 says every byte reads 0x00 after reset
Two legitimate answers (record your choice in the design report):
(a) initialise the array to zero in an initial block — every simulator, and FPGA block RAM that honours init values;
(b) let the control unit write 0x00 to all 256 addresses through the normal ports before the first fetch.
Test T09 reads a never-written address on purpose.

Address comes from a register, not from the instruction
LD R5, [R3] reads DMEM[R[3]] — the contents of R3, not address 3.

Notes: Data memory has the same shape as the register file: synchronous write, combinational read, so a load completes in the cycle its address is valid. It is the only stateful module without a reset port, and the stub tells you to decide how the zero-at-reset requirement is met. Both answers are acceptable; what matters is that you can explain yours at the oral defence. Address and write data both come from the register file, so no ALU is involved in address calculation: DSD-8 has no indexed addressing.

## control_unit: status in, enables and selects out

Handle | Dir | Bits | Connects to | Purpose
opcode, cond | in | 4, 3 | instr_decoder | which instruction; which branch test
flags | in | 4 | flags_reg.flags_out | Z N C V for the branch decision
io_ready | in | 1 | io_bus.io_ready | 0 = stay in the I/O state (stall)
pc_en, pc_load | out | 1 | prog_counter | advance / take the branch target
rf_we | out | 1 | register_file.we | commit wd into R[rd]
mem_we | out | 1 | data_memory.we | commit the ST byte
flags_we | out | 1 | flags_reg.flags_we | commit the ALU flags
wb_sel | out | 2 | write-back mux | 0 ALU · 1 DMEM · 2 imm8 · 3 io_rdata
io_rd, io_wr | out | 1 | io_bus (via glue) | request, held until io_ready
halted, retire | out | 1 | dsd8_cpu outputs | after HLT; one pulse per instruction

control_unit

FSM · your microarchitecture

flags_we

wb_sel

halted

retire

clk

rst_n

pc_en

pc_load

4

3

opcode

rf_we

4

cond

flags

mem_we

io_rd

io_ready

io_wr

2

Outputs are 'output reg'
Decode them from the state in an always @(*) block (Lecture 4, process 3). The stub's clocked block is only a latch-free placeholder: clocked outputs arrive one cycle late.

No io_dir input
The frozen ports cannot tell IN from OUT. Qualify io_rd, io_wr and rf_we with the decoder's io_dir inside dsd8_cpu (slide 22).

Notes: The control unit is the one module whose structure the spec leaves to you: single-cycle, multi-cycle (recommended) or pipelined. Its interface is fixed, though, and the interface already tells you a lot. Inputs are status: what instruction, which condition, what the flags say, whether the peripheral is ready. Outputs are enables (things that commit state at the next edge), selects (wb_sel), and two status outputs, halted and retire. Two consequences of the frozen ports are worth discussing with your team early: the outputs are declared reg but should normally be decoded combinationally from the state, and IN versus OUT has to be resolved outside this module because io_dir is not an input. These are interface facts, not a finished FSM: the state diagram and timing are yours to design and defend.

## io_bus: port decode and the ready handshake

Port | Name | Access | Function
0x00 | SWITCHES | read | eight slide switches
0x01 | BUTTONS | read | {3'b000, btnU, btnD, btnL, btnR, btnC}
0x02 | LEDS | write | eight LEDs, value latched
0x10 / 0x11 | SEG_VALUE / SEG_ENABLE | write | 7-seg value (hex) / digit enables
0x20–0x22 | UART_TX / RX / STATUS | w / r / r | status: bit 0 tx_busy, bit 1 rx_valid
0x30 / 0x31 | TIMER_COUNT / CTRL | r / w | free-running count / enable, clear
0x40 | SLOW_ECHO | r / w | echoes last write after 0–7 stall cycles
other | unmapped | – | read 0x00, write discarded, never stalls

CPU side
(frozen)

io_bus

decode + handshake

io_port

switches

io_wdata

buttons

io_rd

leds

io_wr

seg_value

io_rdata

seg_enable

io_ready

periph_*

board side
(adjustable)

R19–R21: the handshake
Request (io_rd / io_wr) stays high and port, data stay stable until io_ready = 1; no architectural state may change while waiting. No port may hold io_ready low forever. The stub ties io_ready = 0: a CPU wired to it hangs on the first IN/OUT.

Ports 0x00–0x3F (and 0x40) are reserved by the spec; 0x41–0xFF are free for extensions.

periph_* → sim/peripherals.v (UART, timer, SLOW_ECHO)

Notes: io_bus sits outside dsd8_cpu. Its CPU side is frozen by section 7.1; its board side in the stub is a starting design you may adjust, because no external testbench binds to it. Two rules from the port map matter for conformance: unmapped ports read 0x00 and ignore writes, and SLOW_ECHO at 0x40 is the test peripheral that holds io_ready low for a random 0 to 7 cycles, so it is the one place your stall logic is exercised. The stub deliberately ties io_ready low, so the first IN or OUT hangs until you implement the decode.

## Wiring it together

Part 3

From eleven separate files to one processor: the system view, the datapath, the glue, the control signals and the timing rules

3

Notes: Part 3: Wiring it together. From eleven separate files to one processor: the system view, the datapath, the glue, the control signals and the timing rules.

## System view: the core and its two neighbours

dsd8_cpu

inside view: next slide

io_port[7:0]

io_bus
decode ports
hold io_ready low
to stall

switches[7:0]

instr_memory
512 × 16
$readmemh(IMAGE)

imem_addr[8:0]

prog_counter

instr_decoder

io_wdata[7:0]

io_rd

buttons[4:0]

imem_data[15:0]

register_file

flags_reg

alu

data_memory

io_wr

leds[7:0]

control_unit

glue: muxes, retire

io_rdata[7:0]

io_ready

seg_*

7-seg driver
in dsd8_top

Not drawn
clk and rst_n go to every sequential module. rst_n is synchronous and active-low everywhere.

periph_*

seg, an

peripherals
UART · timer · SLOW_ECHO

→ halted LED / output

Frozen boundary
imem_*, io_* and retire_* are the only way in or out of the core.

halted

retire, retire_*

tb_dsd8 trace writer → dut.trace
simulation only; on the board these are unconnected

Notes: This is the system one level above the core. The core talks to exactly two things: the instruction memory, through a 9-bit address and a 16-bit word, and the I/O bus, through six signals. Everything else leaves through the status and trace outputs: halted, retire and the nine retire_ buses. On the board, the I/O bus connects to switches, buttons, LEDs and the seven-segment driver; in simulation the trace writer in tb_dsd8 listens to retire. Because all of this is frozen, two teams' cores are interchangeable in the harness, which is what makes conformance grading objective.

## Inside dsd8_cpu: the datapath

out: pc_en pc_load rf_we mem_we flags_we
wb_sel io_rd io_wr halted retire

data wire

control net (control_unit)

glue logic in dsd8_cpu

junction: wires connect

gap: crossing, no connection

rf_we

control_unit

sel

opcode

cond

imm8

flags

io_ready

instr_
decoder

register_
file

rf_we

rd1

op ← opcode

ALU

wb_sel

to / from io_bus
io_port ← decoder.port
io_wdata ← rd2 (= R[rd])
io_rd, io_wr ← control, qualified by io_dir
io_rdata → WB mux input 3
io_ready → control_unit
retire_* taps: slide 33

pc_en, pc_load

PC
prog_
counter

instr_
memory
outside the core

imem_addr / imem_data

rs1

rs2

ra1

rd1

result

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
flags_reg

Z N C V

→ flags

port → io_port

io_dir → glue

io_wdata

flags_we

io_rdata

3

data_
memory

addr

rdata

1

addr9 → branch_addr

wd: write-back data

mem_we

Notes: Read the datapath left to right. The PC addresses the instruction memory, which sits outside the core; the word comes back as imem_data and the decoder slices it. rs1 always drives read port 1. Read port 2 is driven by a small multiplexer: rs2 for R-format instructions, rd for ST and OUT, because those keep their data register in bits 11:9. rd1 feeds the ALU's first operand and the data-memory address; rd2 feeds the ALU's second operand, the data-memory write data and io_wdata. The write-back multiplexer chooses what goes into R[rd]: 0 ALU result, 1 memory data, 2 the immediate, 3 io_rdata; its output loops back along the bottom into wd. addr9 loops back along the bottom-left into the PC. Control nets are drawn as red tags instead of wires to keep the picture readable; every tag names the control_unit output that drives that input. The gap on rd2 where rd1 passes down to data memory is a crossing, not a connection.

## The glue: logic that lives in dsd8_cpu, not in a module

1 · Write-back multiplexer

selects wd for the register file

case (wb_sel)
2'd0: wd = alu_result;
2'd1: wd = dmem_rdata;
2'd2: wd = imm8;
2'd3: wd = io_rdata;
endcase

2 · Read-port-2 select

ST and OUT read the rd field

assign ra2 = (opcode == 4'h3 ||
opcode == 4'hE)
? rd : rs2;

3 · IN / OUT qualification

control_unit cannot see io_dir

// one possible scheme:
assign io_rd = cu_io_rd & ~io_dir;
assign io_wr = cu_io_wr & io_dir;
// and no rf_we for OUT

4 · retire_* shaping

zero unused fields, show new flags

assign retire_rf_addr =
rf_we ? rd : 3'd0;
assign retire_flags = flags_we
? alu_flags : flags_out;

Code shown is illustrative wiring, not a required implementation; signal names like cu_io_rd and alu_flags are local wires you choose.

Notes: dsd8_cpu is often described as 'just wires', but four small pieces of logic have no module of their own and must live here. The write-back multiplexer: its encoding is fixed by the comment on wb_sel in control_unit.v. The read-port-2 select: needed because of the ST and OUT operand positions. IN versus OUT: opcode 0xE covers both and only bit 8 distinguishes them, but bit 8 is not an input to the frozen control unit, so the team has to agree how io_dir qualifies the I/O requests and the register write. The fourth is retire shaping, covered in Part 4. Agree these between the three members early; they are integration decisions, not anyone's module.

## Control unit: what it listens to, what it drives

instr_decoder

control_unit

state register
process 1 · clocked

next-state logic
process 2 · opcode, cond, flags, io_ready

output logic
process 3 · state (+ inputs)

pc_en, pc_load

prog_counter

opcode[3:0]

cond[2:0]

rf_we

register_file.we

flags_we

flags_reg

flags_reg

flags[3:0]

mem_we

data_memory.we

wb_sel[1:0]

write-back mux

io_bus

clk, rst_n

io_ready

io_rd, io_wr

io_bus (via io_dir glue)

halted

dsd8_cpu.halted

retire

trace / retire_*

Every enable commits state at the NEXT rising edge. A control output is a promise about that edge.

Notes: This is the control unit seen from outside, drawn in the three-process style from Lecture 4: a state register, next-state logic that reads opcode, cond, flags and io_ready, and output logic. Inputs are all status signals from the datapath; outputs are enables, one select, and two status outputs. The enables are the key idea: rf_we, mem_we, flags_we and pc_en do nothing by themselves during the cycle; they decide what happens at the next rising edge. Whether an output depends only on the state (Moore) or also on an input such as io_ready or flags (Mealy) is your design decision, and it matters for branch and I/O timing.

## Control signals per instruction (spec §6.2)

Instr | rf_we | mem_we | io_rd | io_wr | flags_we | wb_sel | pc_load | Watch out
NOP | 0 | 0 | 0 | 0 | 0 | – | 0
LDI | 1 | 0 | 0 | 0 | 0 | 2 (imm8) | 0 | imm8 comes straight from the decoder
LD | 1 | 0 | 0 | 0 | 0 | 1 (DMEM) | 0 | address = R[rs1]; LD does not set flags
ST | 0 | 1 | 0 | 0 | 0 | – | 0 | data = R[bits 11:9] via ra2 select
ADD SUB AND OR XOR | 1 | 0 | 0 | 0 | 1 | 0 (ALU) | 0
SHL SHR | 1 | 0 | 0 | 0 | 1 | 0 (ALU) | 0 | rs2 ignored
CMP | 0 | 0 | 0 | 0 | 1 | – | 0 | the only flags-without-register row
JMP | 0 | 0 | 0 | 0 | 0 | – | 1
Bcc | 0 | 0 | 0 | 0 | 0 | – | taken | taken = f(cond, flags)
IN | 1 | 0 | 1 | 0 | 0 | 3 (io) | 0 | commit only when io_ready = 1
OUT | 0 | 0 | 0 | 1 | 0 | – | 0 | hold io_wr until io_ready = 1
HLT | 0 | 0 | 0 | 0 | 0 | – | 0 | and pc_en = 0 from now on

Read it as 'value in the commit cycle'
In a multi-cycle design these are the values in the cycle that commits the instruction; in every other cycle the enables must be 0. pc_en = 1 in that same cycle for every instruction except HLT.

Notes: This is the control-signal table from the spec. Each row is one instruction; each column is one control output. It does not say which state or cycle a signal is asserted in: that depends on your microarchitecture. A useful way to read it is as the value in the cycle where the instruction commits its result. Outside that cycle, every enable should be low, otherwise you write something twice or write garbage. Two rows catch people: CMP, which sets flags but must not write a register, and Bcc, where pc_load is a function of the condition and the flags.

## Which wires each instruction actually uses

Instruction | Reads | Travels through | Commits | Enables at the commit edge
LDI rd, k | decoder.imm8 | WB mux in 2 | R[rd] | rf_we, pc_en
LD rd, [rs1] | rd1 = R[rs1] | data_memory.addr → rdata → WB mux in 1 | R[rd] | rf_we, pc_en
ST [rs1], rs | rd1 = R[rs1], rd2 = R[rs] | addr = rd1, wdata = rd2 (ra2 = rd) | DMEM[R[rs1]] | mem_we, pc_en
ADD … SHR | rd1, rd2 | ALU result → WB mux in 0; flags → flags_reg | R[rd], flags | rf_we, flags_we, pc_en
CMP rs1, rs2 | rd1, rd2 | ALU flags → flags_reg (result unused) | flags | flags_we, pc_en
JMP a | decoder.addr9 | prog_counter.branch_addr | PC | pc_en, pc_load
Bcc a | addr9, cond, flags | branch decision → pc_load | PC | pc_en, pc_load = taken
IN rd, p | decoder.port | io_port; io_rdata → WB mux in 3 | R[rd] | io_rd until ready; rf_we, pc_en
OUT p, rs | port, rd2 = R[rs] | io_port, io_wdata | (peripheral) | io_wr until ready; pc_en
HLT | – | – | nothing, ever again | halted = 1; pc_en = 0

Exercise for each team
Take a highlighter to the datapath slide (21) and trace one row at a time. Every wire you never highlight is either glue you can simplify or a bug waiting to happen.

Notes: This table connects the datapath picture to the instruction set. For each instruction it lists which outputs of the register file or decoder are read, which path the data takes, what state is committed and which enables must be high when it is committed. Use it during integration: if LD works but ST does not, the difference is the ra2 select and the write data path, nothing else. If IN works but OUT does not, look at io_wdata and the io_dir qualification.

## The branch decision: cond selects a flag test

cond | Mnemonic | Taken if | Use after CMP a, b
000 | BEQ | Z = 1 | a = b
001 | BNE | Z = 0 | a ≠ b
010 | BCS | C = 1 | a ≥ b unsigned
011 | BCC | C = 0 | a < b unsigned
100 | BMI | N = 1 | result negative
101 | BPL | N = 0 | result ≥ 0
110 | BVS | V = 1 | signed overflow
111 | BVC | V = 0 | no overflow

Z

is_Bcc

0

is_JMP

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
taken

AND

OR

pc_load

~N

V

5

6

~V

7

No signed less-than branch — on purpose
a < b (signed) is N ≠ V after CMP a, b. Build it from branches:

flags = {Z, N, C, V} from flags_reg

Where it is decided
pc_load is the only output that depends on flags. Decide it from flags_out — the flags of the most recent flag-setting instruction, already committed.

CMP R1, R2
BVS OVF ; V=1: less if N=0
BMI LESS ; V=0: less if N=1
JMP GE
OVF: BPL LESS
JMP GE

cond[2:0]

Notes: A conditional branch tests one flag, selected by the three cond bits; the table is from the spec. In hardware this is an eight-input multiplexer selected by cond, then gated: pc_load is 1 for every JMP and for a Bcc whose test is true. The flags must be the committed ones in flags_out, which is why the CMP must have retired before the branch reads them; in a multi-cycle machine that is automatic. There is deliberately no signed less-than: after CMP a, b the signed comparison is N not equal to V, and the code on the left builds it from BVS, BMI and BPL. Test group T4 requires it.

## I/O timing: IN R3, 0x40 with a three-cycle stall

clk

c1

c2

c3

c4

c5

c6

Rules
• io_rd, io_port held stable c2–c5
• nothing commits while io_ready = 0
• the cycle with io_ready = 1 completes the instruction: R3 ← 5A, PC ← 005, one retire

phase

earlier cycles

request

wait (stall)

complete

next instr

pc

004

005

io_port

–

40

–

io_rd

io_ready

io_rdata

–

5A

–

rf_we, pc_en

retire

rf_we and retire in c5 depend on io_ready (Mealy-style). Alternative: capture io_rdata in a register at the c5 edge and commit one cycle later — then retire moves too.

commit edge

Notes: This waveform shows the handshake from the processor's side for an IN from SLOW_ECHO, which here holds io_ready low for three cycles. The request goes up in c2 and stays up, with io_port stable, until the peripheral answers. During the wait nothing commits: no register write, no PC change, no retire. In c5 io_ready is 1 and io_rdata is valid, so at the rising edge that ends c5 the register file captures 5A, the PC advances and the trace writer sees one retire. Making rf_we depend on io_ready in the same cycle is the simplest scheme; if your team prefers purely state-based outputs, latch io_rdata at the c5 edge and commit in c6, and then the retire moves to c6 as well. The cycle names are deliberately generic: how many cycles precede the request is your microarchitecture.

## Three special situations: reset, stall, halt

Reset

- rst_n is synchronous and active-low in every module.
- On the edge where rst_n = 0: PC = 0x000, R0–R7 = 0, Z N C V = 0, FSM in its start state.
- DMEM reads 0x00 everywhere (initial block or clearing sequence).
- The harness ignores retire while rst_n = 0; the first line must be the instruction at 0x000 — once.

Stall (io_ready = 0)

- Only during IN / OUT.
- No enable may be high: PC, registers, flags and DMEM hold.
- Request, io_port and io_wdata stay stable.
- retire = 0 on every stall cycle; one retire when the transfer completes.

Halt

- HLT retires exactly once: one trace line, flags unchanged.
- halted = 1 from then on; pc_en = 0 forever, PC holds HLT's address.
- No further enables, no further retire.
- The harness stops at halted or at its cycle limit.

Most common reset bug
The first instruction executes twice, or is skipped, because pc_en is high in the cycle reset is released. Check that cycle in the waveform before anything else.

Notes: Three situations break the normal one-instruction-after-another rhythm. Reset puts every architectural element into a known state; data memory is the special case because it has no reset port. A stall happens only during IN and OUT when the addressed peripheral holds io_ready low; the rule is simple: nothing commits and nothing retires until the transfer completes. Halt is permanent: HLT produces its own trace line and then the machine freezes. Each of these is tested by the conformance suite, and each produces a very recognisable trace symptom, which is the subject of Part 4.

## The retire_ interface

Part 4

How one trace line per instruction turns your processor into something that can be checked automatically — and debugged from evidence

4

Notes: Part 4: The retire_ interface. How one trace line per instruction turns your processor into something that can be checked automatically — and debugged from evidence.

## Why a trace: the same program on two machines

tb_dsd8 + YOUR dsd8_cpu
Verilog simulation

retire_* → $fdisplay

dut.trace

diff

first differing line
= the bug

Txx.asm
your program

dsd8asm.py
assembler

Txx.hex
16-bit words

dsd8sim.py
golden reference model

gold.trace

The idea in one sentence
A processor has too many states to check by staring at waveforms, so both machines print one line per completed instruction and a text diff finds the first instruction that went wrong — which instruction, on which line, in which field.

Why your design must cooperate
The golden model knows the ISA; it does not know your FSM. The only thing the two can agree on is the architectural effect of each instruction. retire_* is how your core reports that effect, at the moment it happens.

Notes: This is the verification strategy of the whole project. The same hex image goes into two machines: your Verilog processor inside the supplied harness, and the Python golden model. Each prints one line per instruction that completes. If the two files are identical, your processor did exactly what the ISA says for that program. If they differ, the first differing line names the instruction and the field that went wrong. This is how real processors are verified. The golden model cannot see inside your design, which is why the retire outputs exist: they are the architectural summary your design publishes.

## What 'retire' means

Definition
An instruction retires in the clock cycle in which its effects become permanent: the register, memory, flag and PC updates it causes are committed at the rising edge that ends that cycle. retire = 1 marks that cycle.

cycles →

LDI R1,13

ADD R3,R3,R1

LD R2,[R1]

IN R3,0x40

HLT

HLT retires once; nothing after it

retire

retire

retire

stall: io_ready = 0

retire

retire

Illustrative cycle counts for a multi-cycle design — yours will differ, the rules will not.

Exactly one

retire pulse per instruction — never zero, never two (R22)

In program order

the order the program executes, including taken branches

Never

during reset, during a stall, or after HLT

Values valid

all retire_* describe the retiring instruction in that same cycle

Notes: Retiring is the moment an instruction stops being in progress and becomes history. In a multi-cycle design an instruction occupies several cycles, but only one of them commits its results; that is the retire cycle. The timeline shows five instructions with different lengths: a stalled IN takes longer, but it still retires exactly once. The four rules at the bottom are what the harness and the golden model assume. Break any of them and the diff will show it: zero pulses means missing lines, two pulses means duplicated lines, a retire during a stall means a line with wrong data.

## The ten trace outputs, field by field

Output | Bits | Trace field | Meaning | When nothing was written
retire | 1 | (gate) | a line is written at this edge | —
(harness counter) | – | 1 seq %04d | instruction number, from 0001 | —
retire_pc | 9 | 2 pc %03X | address of the retiring instruction | —
retire_ir | 16 | 3 ir %04X | its instruction word | —
retire_rf_we | 1 | 4 rf_we | 1 if it wrote a register | 0
retire_rf_addr | 3 | 5 rf_addr | which register | must be 0
retire_rf_data | 8 | 6 rf_data %02X | the value written | must be 00
retire_mem_we | 1 | 7 mem_we | 1 if it wrote data memory | 0
retire_mem_addr | 8 | 8 mem_addr %02X | the address written | must be 00
retire_mem_data | 8 | 9 mem_data %02X | the byte written | must be 00
retire_flags | 4 | 10 ZNCV | flags AFTER the instruction | (always shown)

0008 007 46C8 1 3 0D 0 00 00 0000 ; ADD R3, R3, R1

Stale fields fail
Fields 5, 6, 8, 9 must be zero when the matching write-enable is zero — even if the behaviour is right.

Notes: Here are the ten outputs that the harness reads. retire is the gate; the other nine fill fields 2 to 10 of the line. Field 1 is a counter kept by the harness itself. Notice the last column: when an instruction writes no register, fields 5 and 6 must be zero, and when it writes no memory, fields 8 and 9 must be zero. A processor that leaves the last destination register in retire_rf_addr is architecturally correct but fails the comparison. The flags field is always printed and must show the flags after the instruction, whether or not this instruction changed them.

## Where each retire_ output comes from

Commit-cycle scheme: retire is high in the cycle whose rising edge commits the instruction.

field

control_unit.retire

retire

pc

imem_data

rf_we

rf_we ? rd : 0

rf_we ? wd : 0

mem_we

mem_we ? rd1 : 0

mem_we ? rd2 : 0

flags_we ? alu : out

retire glue (in dsd8_cpu)

(direct)

gate

tb_dsd8
samples all ten at the rising edge when rst_n && retire, prints one line

prog_counter.pc

retire_pc

2

3

imem_data

control_unit.rf_we*

retire_ir

retire_rf_we

4

instr_decoder.rd

retire_rf_addr

5

WB mux output (wd)

control_unit.mem_we

retire_rf_data

6

7

register_file.rd1

retire_mem_we

retire_mem_addr

8

register_file.rd2

retire_mem_data

9

alu flags / flags_out

retire_flags

10

* rf_we after any IN / OUT qualification, so OUT never reports a register write. alu = {flag_z, flag_n, flag_c, flag_v}; out = flags_out.

Notes: This diagram assumes the commit-cycle scheme, which fits the frozen ports well: the PC still holds the retiring instruction's address, imem_data still holds its word, and every enable that commits it is high in that cycle. Then each retire output is either a direct copy or a value gated by its enable. Gating is what keeps fields 5, 6, 8 and 9 at zero for instructions that do not write. The flags line is the subtle one, covered two slides from now: in the commit cycle flags_out still holds the old flags, so when flags_we is high the trace must show the ALU's new flags instead. If your team retires one cycle after the commit instead, every value must come from registers captured at the commit edge.

## When the harness samples: ADD R3, R3, R1 at PC 0x007

clk

cycle 1

FETCH

cycle 2

EXECUTE

cycle 3

WRITEBACK

cycle 4

FETCH

state

007

008

pc

imem_data

46C8 (ADD R3,R3,R1)

54A0

wd (WB mux)

0D

…

rf_we flags_we pc_en

retire

flags_out

0010 (from CMP)

0000

R3

00

sample + commit edge

0D

At that edge the harness sees
pc 007, ir 46C8, rf 1 3 0D ✔
flags_out = 0010 ✘ — the CMP's flags, because flags_reg updates at the same edge. Correct field 10 is 0000.

Notes: This waveform is generated from the multiply example's real trace: line 8 is ADD R3, R3, R1 at PC 007, producing 0D with flags 0000, and the instruction before it was a CMP that left flags 0010. In the commit cycle, labelled WRITEBACK here for a simple three-cycle machine, the PC and imem_data still describe the ADD, wd carries 0D and the enables are high. The harness's always @(posedge clk) block runs at the dashed edge and reads values from just before the edge. That is perfect for pc, ir and the register write. But flags_reg is also updated by that edge, so flags_out still shows the old CMP flags. A trace built from flags_out directly lags one instruction in field 10: the classic symptom. The next slide gives two fixes.

## Two ways to report the flags 'after'

A · Retire in the commit cycle, bypass the flags

// all retire_* combinational, valid in the
// cycle where retire = 1
assign retire_flags = flags_we
? {flag_z, flag_n, flag_c, flag_v}
: flags_out;
assign retire_rf_data = rf_we ? wd : 8'h00;
assign retire_pc = pc;

- No extra registers; matches the frozen ports naturally
- Requires every enable of the instruction to be high in the retire cycle

B · Retire one cycle after the commit

always @(posedge clk)
if (!rst_n) ret_q <= 1'b0;
else begin
ret_q <= commit; // 1 cycle late
rf_data_q <= rf_we ? wd : 8'h00;
pc_q <= pc; ir_q <= imem_data;
end
assign retire_flags = flags_out; // now updated

- Flags and registers are already committed when sampled
- Every retire_* must be a captured copy — mixing live and captured values shifts fields by one

Pick one scheme as a team, write it in the design report, and test it
The harness does not care which scheme you use; it cares that all ten values describe the same instruction. Half-and-half designs produce the 'flags lag' or 'whole line shifted by one' symptoms.

Notes: Both schemes are legitimate. Scheme A keeps everything in the commit cycle and adds one multiplexer for the flags: when this instruction writes the flags, show the ALU's new flags; otherwise flags_out is already correct. Scheme B delays the retire pulse by a cycle and captures every value the line needs at the commit edge, so it reads flags_out after it has updated. What does not work is mixing them: for example retiring in the commit cycle but taking flags from flags_out, or retiring a cycle late but taking pc live after the PC has moved. Those mixtures produce exactly the two symptoms the spec warns about.

## What every instruction must report

Instruction | rf_we | rf_addr | rf_data | mem_we | mem_addr | mem_data | flags (field 10)
NOP, JMP, Bcc, HLT | 0 | 0 | 00 | 0 | 00 | 00 | unchanged
LDI rd, k | 1 | rd | k | 0 | 00 | 00 | unchanged
LD rd, [rs1] | 1 | rd | DMEM[R[rs1]] | 0 | 00 | 00 | unchanged
ST [rs1], rs | 0 | 0 | 00 | 1 | R[rs1] | R[rs] | unchanged
ADD SUB AND OR XOR SHL SHR | 1 | rd | result | 0 | 00 | 00 | new
CMP rs1, rs2 | 0 | 0 | 00 | 0 | 00 | 00 | new
IN rd, port | 1 | rd | io_rdata | 0 | 00 | 00 | unchanged
OUT port, rs | 0 | 0 | 00 | 0 | 00 | 00 | unchanged

What the trace cannot see
Branches show up only as the next line's pc. OUT shows up nowhere in its own line — to check an OUT, read the value back (SLOW_ECHO at 0x40 returns the last byte written).

HLT still prints a line
HLT is the last line of every trace. A design that stops retiring one instruction early, or keeps retiring after HLT, fails at the end of every test.

Notes: Use this table when you write your retire glue, and when you predict a trace by hand. Grey zeros are the zero-forcing rule. 'unchanged' means field 10 still prints the current flags, which are whatever the last flag-setting instruction left. The two callouts are about observability, which matters when you design tests in Part 6: anything that does not appear in a trace field can only be checked through its consequences.

## Reading a real trace: the multiply loop

seq | pc | ir | rf_we | rf_addr | rf_data | mem_we | mem_addr | mem_data | ZNCV | source
0006 | 005 | B0A8 | 0 | 0 | 00 | 0 | 00 | 00 | 0010 | CMP R2, R5
0007 | 006 | D00A | 0 | 0 | 00 | 0 | 00 | 00 | 0010 | BEQ DONE (not taken)
0008 | 007 | 46C8 | 1 | 3 | 0D | 0 | 00 | 00 | 0000 | ADD R3, R3, R1
0009 | 008 | 54A0 | 1 | 2 | 06 | 0 | 00 | 00 | 0010 | SUB R2, R2, R4
0010 | 009 | C004 | 0 | 0 | 00 | 0 | 00 | 00 | 0010 | JMP LOOP
0011 | 004 | 1A00 | 1 | 5 | 00 | 0 | 00 | 00 | 0010 | LDI R5, 0
0004 | 003 | 3640 | 0 | 0 | 00 | 1 | 10 | A5 | 0000 | ST [R1], R3 (memory test)

Line 0006

CMP writes nothing (fields 4–9 zero) but field 10 changes: 7 − 0 gives C = 1 (no borrow).

Line 0007

Line 0008

BEQ not taken: no fields, and the next line is at pc 007 = PC + 1.

ADD writes R3 = 0x0D; flags become 0000. The CMP flags are gone.

Line 0010 → 0011

JMP shows nothing itself; the jump is visible only as pc 009 → 004.

ST line

mem fields 1 10 A5: DMEM[0x10] ← 0xA5; rf fields all zero.

Notes: These lines are the real output of the golden model for the multiply example from the spec (13 times 7 by repeated addition) plus one line from the memory test in Part 6. Train yourself to read them field by field. The CMP line writes nothing but changes field 10. The BEQ line writes nothing, and you can only tell it was not taken from the next line's PC. The ADD and SUB lines show register writes and new flags. The JMP is invisible except as a PC discontinuity. The ST line is the only kind with mem_we = 1.

## Debugging from the first differing line

What the diff shows | Almost always
Every line right, but shifted by one instruction | retire pulses a cycle early or late relative to the commit (or retire_* mixes live and captured values)
Field 10 lags one instruction | retire_flags taken from flags_out in the commit cycle — see slide 35
Non-zero rf_addr / rf_data on a line with rf_we = 0 | missing zero-forcing in the retire glue
No lines at all | retire never pulses (the stub ties it to 0), or rst_n held low
Missing or doubled lines for some instructions | retire high for 0 or 2 cycles on one path: taken branch, stall, HLT
Trace stops at the first IN / OUT | io_ready never 1 (io_bus stub), or the CPU ignores it
A register is wrong several lines after a CMP | rf_we asserted for CMP
ST writes the right byte to the wrong address | ra2 select / operand routing: address is rs1, data is bits 11:9
First line twice, or line 0001 missing | pc_en during the reset-release cycle
x or z appears in a field | uninitialised DMEM, PC past the end of the image, or an undriven wire

Method: find the first differing line → name the field → open the waveform at that instruction's retire cycle only.

Notes: Each row starts from what you will actually see in the diff and gives the cause it almost always turns out to be; the first rows come straight from the spec's pitfalls table. The method at the bottom is the important part: never start from the waveform. Start from the first differing line, decide which field is wrong, and only then open the waveform, and only at the retire cycle of that one instruction. That turns a two-day hunt into a ten-minute check.

## Using retire_* in your own testbenches

// watch the core only through its retire_ outputs
integer n = 0; reg seen_hlt = 0; reg [7:0] shadow [0:7];
always @(posedge clk) if (rst_n && retire) begin
n = n + 1;
if (seen_hlt) $display("ERROR: retire after HLT");
if (retire_ir == 16'hF000) seen_hlt <= 1'b1;
if (!retire_rf_we && (retire_rf_addr !== 3'd0 ||
retire_rf_data !== 8'h00))
$display("ERROR %0d: stale rf fields, pc=%03h", n, retire_pc);
if (^{retire_pc, retire_ir, retire_flags} === 1'bx)
$display("ERROR %0d: X in trace", n);
if (retire_rf_we) shadow[retire_rf_addr] <= retire_rf_data;
end
// at the end: compare shadow[] with the values your program should leave

Protocol checks
one retire per instruction, nothing after HLT, no X, zeroed fields — on every test, for free.

Shadow state
rebuild R0–R7 (and DMEM) from the trace alone; check end-of-program values without peeking inside the core.

Count cycles
cycles between retires = CPI of each instruction; report it for the performance table.

Stop early
$finish on the first error: the first failure is the only one worth reading.

Unit tests first, trace second
Each module still needs its own self-checking testbench (§5; the ALU's must be constrained-random). The trace tests the integration of modules that already work.

Notes: retire is not only for the grader. Because it summarises each instruction, a small always block in your own testbench can check protocol rules on every simulation: exactly what this code does. The shadow register file is a powerful trick: by applying every reported register write to an array, your testbench knows the architectural register contents at any point without hierarchical references into your design. Counting cycles between retire pulses gives cycles per instruction. These checks complement the golden-model diff; they do not replace the unit testbenches each member must write for their own modules.

## The Python assembler

Part 5

How dsd8asm.py turns lines of text into the 16-bit words that instr_memory loads — and how to use it to build your own tests

5

Notes: Part 5: The Python assembler. How dsd8asm.py turns lines of text into the 16-bit words that instr_memory loads — and how to use it to build your own tests.

## The language the assembler accepts

; comments start with a semicolon
LOOP: LDI R1, 0x0A ; label = name + colon
ADD R2, R2, R1 ; R0..R7, any case
CMP R2, R3
BNE LOOP ; target: label or number
LD R4, [R1] ; address register in [ ]
ST [R1], R4 ; address first, then data
OUT 0x02, R2 ; port first for OUT
IN R4, 0x00 ; register first for IN
MOV R5, R4 ; becomes OR R5, R4, R4
HLT

Rule | Detail
One instruction per line | a label may share the line or stand alone
Numbers | 13, 0x0D, 0b1101 (Python int(x, 0)); no leading zeros: write 8, not 08
Immediates | masked to 8 bits: LDI R1, 300 → 44; LDI R1, -1 → 0xFF
Branch targets | labels or absolute addresses, masked to 9 bits
Operand order | ST [addr], data · OUT port, reg · IN reg, port
Pseudo-ops | MOV rd, rs → OR rd, rs, rs · NOT needs a register holding 0xFF (spec §2)
Reserved bits | always emitted as zero

The assembler trusts you
The core algorithm does little range checking: R8, a port above 0xFF or a target above 0x1FF is silently masked or overflows into the next field. Check the listing.

Notes: This is the assembly language from the spec, section 2. Most of it is what you expect from any assembler. Three details cause real bugs: the operand order of ST and OUT, which follow the instruction's meaning rather than the bit layout; immediates being masked rather than rejected, which is handy for negative constants but hides typos; and the absence of range checks in the core two-pass algorithm. The habit that protects you is to read the listing, address, word and source line, for every new program before you simulate it.

## How it works: clean, pass 1, pass 2, write

1 clean

strip ';' comments and blank lines

2 pass 1

number the instructions; record each label's address

3 pass 2

split mnemonic + operands; resolve labels; call the encoder

4 write

one 4-digit hex word per line → .hex

5 load

instr_memory: $readmemh(IMAGE, mem)

LOOP: LDI R5,0
CMP R2,R5
BEQ DONE
DONE: OUT 2,R3

labels = {
'LOOP': 0x004,
'DONE': 0x00A }

BEQ DONE
→ enc_B(0, 0x00A)
→ 0xD00A

1A00
B0A8
D00A
E702

mem[004] = 1A00
mem[005] = B0A8
mem[006] = D00A

Why two passes
BEQ DONE appears before DONE is defined (a forward reference). Pass 1 only counts and collects labels, so that by pass 2 every label already has an address.

Addresses count instructions, not lines
Comment lines, blank lines and label-only lines take no address. The listing — address, word, source — is the ground truth for what instr_memory holds.

Notes: The assembler is a classic two-pass design. Cleaning throws away comments and blank lines. Pass 1 walks the cleaned lines with a counter that starts at zero and increases by one per instruction; whenever it sees a label it stores the current counter value. Pass 2 walks the instructions again, now knowing every label's address, parses the operands and calls the right encoder for the instruction's format. The words are written one per line in hexadecimal, which is exactly the format Verilog's $readmemh reads. The example values under each step are from the multiply program.

## Pass 1 on the multiply example

Addr | Source line | Label?
000 | LDI R1, 13
001 | LDI R2, 7
002 | LDI R3, 0
003 | LDI R4, 1
004 | LOOP: LDI R5, 0 | LOOP = 0x004
005 | CMP R2, R5
006 | BEQ DONE
007 | ADD R3, R3, R1
008 | SUB R2, R2, R4
009 | JMP LOOP
00A | DONE: OUT 0x02, R3 | DONE = 0x00A
00B | HLT

labels = {}; pc = 0; prog = []
for s in lines: # cleaned lines
m = re.match(r'^(\w+)\s*:\s*(.*)$', s)
if m: # 'NAME: rest'
labels[m.group(1).upper()] = pc
s = m.group(2).strip()
if not s: continue # label alone
prog.append((pc, s)); pc += 1

Result
labels = { 'LOOP': 0x004, 'DONE': 0x00A }
12 instructions → 12 words, addresses 0x000–0x00B

Label names
Letters, digits, underscore; stored in upper case, so loop and LOOP are the same label. Reusing a name silently keeps the later address.

Notes: Here is pass 1 applied to the multiply program, with the actual addresses. LOOP is the fifth instruction, so it gets address 4; DONE gets address 10, hex 00A. The code box is the label-collecting loop of the core algorithm: a regular expression splits 'NAME: rest of line', records NAME with the current counter, and if nothing follows the colon the line consumes no address. Because labels are stored in upper case, label names are case-insensitive, and a duplicate label quietly overwrites the earlier one, another reason to read the listing.

## Pass 2: one encoder per format, just shifts and ORs

def enc_R(op, rd, rs1, rs2): return (op<<12)|(rd<<9)|(rs1<<6)|(rs2<<3)
def enc_I(op, rd, imm): return (op<<12)|(rd<<9)|(imm & 0xFF)
def enc_M(op, ra, rb): return (op<<12)|(ra<<9)|(rb<<6)
def enc_J(op, addr): return (op<<12)|(addr & 0x1FF)
def enc_B(cond, addr): return (0xD<<12)|(cond<<9)|(addr & 0x1FF)
def enc_P(r, is_out, port): return (0xE<<12)|(r<<9)|(is_out<<8)|(port & 0xFF)

Worked example: ADD R3, R3, R1 → enc_R(0x4, 3, 3, 1)

Term | Value | Bits 15 … 0 | Hex
op << 12 | 0x4 << 12 | 0100 000 000 000 000 | 0x4000
rd << 9 | 3 << 9 | 0000 011 000 000 000 | 0x0600
rs1 << 6 | 3 << 6 | 0000 000 011 000 000 | 0x00C0
rs2 << 3 | 1 << 3 | 0000 000 000 001 000 | 0x0008
OR of all | | 0100 011 011 001 000 | 0x46C8

Check it against the spec
0x46C8 is row 2 of the spec's worked-encoding table. Hand-check three or four encodings before you trust any toolchain — including your own decoder.

Encoder ↔ decoder
The encoder's shift amounts (12, 9, 6, 3, 8) are exactly the decoder's bit slices. They are the same table read in opposite directions.

Notes: Every instruction format has a tiny encoder that places fields at fixed bit positions with shifts and combines them with OR. The masks on imm, addr and port are why out-of-range immediates are truncated instead of rejected. The worked example is ADD R3, R3, R1 from the spec's table: opcode 4 moved to bits 15 to 12, rd 3 to bits 11 to 9, rs1 3 to bits 8 to 6, rs2 1 to bits 5 to 3, giving 0x46C8. Point out to students that the decoder they write in instr_decoder.v must undo exactly these shifts; if encoder and decoder disagree anywhere, every program using that format breaks.

## Mnemonic → encoder: where the operand-order traps are

You write | Encoder call | Example → word | Note
NOP / HLT | 0 / 0xF << 12 | HLT → F000 | no operands
LDI rd, k | enc_I(1, rd, k) | LDI R2, 13 → 140D
LD rd, [rs1] | enc_M(2, rd, rs1) | LD R5, [R3] → 2AC0 | brackets stripped
ST [rs1], rs | enc_M(3, rs, rs1) | ST [R3], R0 → 30C0 | data reg goes to bits 11:9
ADD…XOR rd, rs1, rs2 | enc_R(op, rd, rs1, rs2) | ADD R3, R3, R1 → 46C8
SHL / SHR rd, rs1 | enc_R(op, rd, rs1, 0) | SHR R6, R7 → ADC0 | rs2 field = 0
CMP rs1, rs2 | enc_R(0xB, 0, rs1, rs2) | CMP R2, R5 → B0A8 | rd field = 0; operands shift right
JMP a | enc_J(0xC, a) | JMP 0x004 → C004 | cond field = 000
Bcc a | enc_B(cond, a) | BCC 0x011 → D611 | cond from the mnemonic
IN rd, port | enc_P(rd, 0, port) | IN R1, 0x22 → E222 | dir = 0
OUT port, rs | enc_P(rs, 1, port) | OUT 0x02, R3 → E702 | written port-first, encoded reg-first
MOV rd, rs | enc_R(7, rd, rs, rs) | MOV R5, R4 → 7B20 | pseudo-op: OR

Every example word above was produced by the assembler algorithm and matches the spec's worked-encoding table where it appears there.

Notes: This table is the whole of pass 2 for each mnemonic. The red rows are where the text order and the bit order differ. ST is written address first, but its data register is encoded in the rd position. CMP has no destination, so its first operand goes into the rs1 field, not rd. OUT is written port first but encoded register first. If your decoder or your control unit has the ST or OUT operands the wrong way round, these rows are why; the trace will show it as the wrong mem_addr and mem_data, or the wrong byte on the LEDs.

## From .asm to .hex to instr_memory

Addr | Word | Source
000 | 120D | LDI R1, 13
001 | 1407 | LDI R2, 7
002 | 1600 | LDI R3, 0
003 | 1801 | LDI R4, 1
004 | 1A00 | LOOP: LDI R5, 0
005 | B0A8 | CMP R2, R5
006 | D00A | BEQ DONE
007 | 46C8 | ADD R3, R3, R1
008 | 54A0 | SUB R2, R2, R4
009 | C004 | JMP LOOP
00A | E702 | DONE: OUT 0x02, R3
00B | F000 | HLT

// mul.hex
120D
1407
1600
1801
1A00
B0A8
D00A
46C8
54A0
C004
E702
F000

mul.hex

instr_memory #(
.IMAGE("mul.hex")
) imem (
.clk (clk),
.addr(imem_addr),
.data(imem_data));
// $readmemh fills
// mem[0x000..0x00B];
// mem[0x00C..0x1FF]
// stay X

listing (read this first)

words, labels = assemble(open('mul.asm').read())
with open('mul.hex', 'w') as f:
for w in words: f.write(f'{w:04X}\n')

Notes: Three views of the same program. The listing pairs each address and word with its source line; the hex file is just the words, one per line, which $readmemh reads into consecutive memory locations starting at 0; and the instance at the right is how the harness, or dsd8_top, picks which image to load through the IMAGE parameter. The two-line writer at the bottom shows how little separates the assembler's word list from a loadable file. Remind students that addresses past the last word stay X in this ROM.

## The golden simulator and the run–diff loop

- dsd8sim.py is an instruction-set simulator: it executes one whole instruction per step and prints the same ten-field line. It knows nothing about cycles.
- Same hex, same harness, every time. Never edit a golden trace by hand to make a test pass.
- make conformance runs all 40 supplied tests; put your own tests in the same loop.
- Exact command-line options: see the README and --help of the tools in your repo copy.

The habit that wins the project
Every bug you fix gets a test that would have caught it. Your own tests then become a regression suite that protects the 40 you already pass.

1 Write
Txx_name.asm: one behaviour, header comment, ends in HLT

6 Fix & repeat
then rerun every earlier test (regression)

2 Assemble
dsd8asm.py → Txx.hex; read the listing

↻

5 Diff
first differing line → instruction + field

3 Predict
dsd8sim.py runs the same hex → gold.trace

4 Simulate
tb_dsd8 with IMAGE = Txx.hex → dut.trace

Notes: This loop is the daily work of the project. The golden simulator is an instruction-set simulator: it applies the architectural effect of one instruction per step, prints the trace line, and has no notion of clock cycles, states or stalls. That is exactly why it is a good reference for a multi-cycle or pipelined design. The step people skip is the last one: after a fix, rerun everything. The Makefile target from the starter repository does that for the supplied suite; students should add their own tests to the same flow. I have not shown command-line flags for the Python tools on purpose; use the versions and README in your repository.

## Writing test programs systematically

Part 6

From 'it seems to work' to evidence: layers of tests, rules that make tests useful, worked examples and random programs

6

Notes: Part 6: Writing test programs systematically. From 'it seems to work' to evidence: layers of tests, rules that make tests useful, worked examples and random programs.

## A test plan in five layers

fewer,
broader ↑

Random programs vs the golden model
thousands of instructions, nobody's assumptions

Layer | Catches
Unit | wrong slice, wrong flag, latch, reset value
Single instr. | control-table row, WB select, retire fields
Corner | carry convention, operand order, timing of flags
Integration | sequencing, branches in loops, I/O stalls
Random | everything nobody thought of

Integration programs
multiply, sort, UART echo: realistic instruction mixes (T36–T40)

Corner and interaction programs
flag edges, aliasing, read-after-write, branch both ways

Single-instruction programs
one opcode, distinct values, every field visible in the trace

Unit testbenches
each module alone, self-checking; ALU constrained-random (§5)

many,
narrow ↓

Climb in order
A failure in a higher layer is cheap to debug only if the layers below already pass.

Notes: Organise testing in layers, from narrow to broad. Unit testbenches check each module in isolation and are each member's own responsibility. Single-instruction programs check one row of the control table at a time. Corner programs target the places the spec warns about. Integration programs, including the supplied T36 to T40, check realistic sequences. Random programs, compared against the golden model, find what nobody thought to test. The table on the right is what each layer is good at catching. Work bottom to top: when a random program fails, you want to already trust every individual instruction.

## Six rules for a test program that finds bugs

One behaviour per program

Name it (T41_sub_borrow.asm) and say in a header comment what it proves and what the final state should be.

1

Make every result visible

Put results in registers or memory so they appear in fields 4–9. OUT is invisible in the trace: read it back via SLOW_ECHO.

2

Choose values that expose bugs

0xA5 / 0x5A, operands that differ, SUB both ways round. 0 + 0 = 0 passes with a broken adder.

3

Exercise both sides of every decision

branch taken and not taken; each flag set and cleared; first and last address.

4

End with HLT and a verdict

OUT 0x02 with 0x01 for pass, 0xEE for fail, so the board demo shows the same result.

5

Let the golden model predict

Hand-predict a few lines to understand them; let dsd8sim.py produce the full expected trace.

6

Notes: These six rules separate a test from a demonstration. The question to keep asking is: what broken design would still pass this test? A program that adds 0 and 0 passes with an adder that always outputs 0. A SUB tested only with a greater than b never exercises the borrow. A branch tested only when taken never checks the fall-through path. Rule 2 matters because of observability: the trace only shows register writes, memory writes and flags, so results must be steered into those, and OUT has to be read back to be checked.

## Worked test 1: ALU flag corners

seq | pc | ir | rf | data | ZNCV | What it proves
0001 | 000 | 127F | 1 1 | 7F | 0000
0002 | 001 | 1401 | 1 2 | 01 | 0000
0003 | 002 | 4650 | 1 3 | 80 | 0101 | N=1, V=1: signed overflow
0004 | 003 | 18FF | 1 4 | FF | 0101
0005 | 004 | 4B10 | 1 5 | 00 | 1010 | Z=1, C=1: carry out
0006 | 005 | 5C90 | 1 6 | 00 | 1010 | Z=1, C=1: no borrow
0007 | 006 | 5CA0 | 1 6 | 02 | 0000 | C=0: borrow
0008 | 007 | 1E80 | 1 7 | 80 | 0000
0009 | 008 | 5DD0 | 1 6 | 7F | 0011 | V=1: −128 − 1 overflows
0010 | 009 | ADC0 | 1 6 | 40 | 0000 | 0x40, not 0xC0
0011 | 00A | 9DC0 | 1 6 | 00 | 1010 | 0x00 with C=1
0012 | 00B | F000 | 0 0 | 00 | 1010 | HLT keeps the flags

; T-flags: one corner per instruction
LDI R1, 0x7F
LDI R2, 0x01
ADD R3, R1, R2 ; 7F+01: N V
LDI R4, 0xFF
ADD R5, R4, R2 ; FF+01: Z C
SUB R6, R2, R2 ; 1-1: Z C
SUB R6, R2, R4 ; 1-FF: borrow
LDI R7, 0x80
SUB R6, R7, R2 ; 80-1: V
SHR R6, R7 ; logical
SHL R6, R7 ; Z C
HLT

Golden-model output, not hand-written
Each ALU line writes a distinct register value and shows its flags, so a wrong carry or overflow is pinned to one line.

Notes: This program targets the flag definitions, especially the two the spec warns about: carry after subtraction means no borrow, and SHR is logical. The trace on the right is the golden model's real output for this program. Each line both writes a register, so field 6 shows the result, and prints the flags, so field 10 pins down exactly which flag is wrong if your ALU disagrees. Notice SUB R6, R2, R4: 1 minus 255 needs a borrow, so C is 0. And SUB R6, R7, R2: minus 128 minus 1 is not representable, so V is 1.

## Worked tests 2 and 3: memory and branches

; T-mem: never-written read, write, read back
LDI R1, 0x10
LD R2, [R1] ; must be 00, not X
LDI R3, 0xA5
ST [R1], R3 ; DMEM[10] <- A5
LD R4, [R1] ; read back A5
LDI R1, 0xFF ; top address
ST [R1], R1 ; addr = data reg
LD R5, [R1]
HLT

Line | Expected (golden model)
0002 | 0002 001 2440 1 2 00 0 00 00 0000
0004 | 0004 003 3640 0 0 00 1 10 A5 0000
0007 | 0007 006 3240 0 0 00 1 FF FF 0000

Branch test: 14 lines, ends at pc 00F with R7 = 02.

; T-branch: both sides of BCC / BCS
LDI R7, 0 ; pass counter
LDI R1, 1
LDI R2, 3
LDI R3, 5
CMP R2, R3 ; 3 vs 5: C=0
BEQ FAIL ; must fall through
BCC OK1 ; must be taken
JMP FAIL
OK1: ADD R7, R7, R1
CMP R3, R2 ; 5 vs 3: C=1
BCC FAIL
BCS OK2
JMP FAIL
OK2: ADD R7, R7, R1
OUT 0x02, R7 ; 2 = pass
HLT
FAIL: LDI R7, 0xEE
OUT 0x02, R7
HLT

Notes: The memory test reads a never-written byte first, which is exactly T09's check of the zero-at-reset requirement, then writes and reads back, and finally uses the same register as address and data at the top address. The expected lines on the left are golden-model output: line 2 must show rf_data 00, line 4 is the store with mem fields 1 10 A5, line 7 stores FF at FF. The branch test checks both sides of BCC and BCS after a CMP with known operands. Any wrong decision sends execution to FAIL at address 010, which is immediately visible in the pc field, and the program still ends cleanly with a verdict on the LEDs.

## Worked test 4: I/O, including the stall

; T-io: switches -> LEDs, SLOW_ECHO read-back
IN R1, 0x00 ; slide switches
OUT 0x02, R1 ; copy to LEDs
LDI R2, 0x5A
OUT 0x40, R2 ; SLOW_ECHO: may stall
IN R3, 0x40 ; read back: must be 5A
CMP R3, R2
BNE FAIL
LDI R7, 0x01 ; PASS code
OUT 0x02, R7
HLT
FAIL: LDI R7, 0xEE ; FAIL code
OUT 0x02, R7
HLT

seq | pc | ir | rf | data | ZNCV
0001 | 000 | E200 | 1 1 | 3C | 0000
0002 | 001 | E302 | 0 0 | 00 | 0000
0003 | 002 | 145A | 1 2 | 5A | 0000
0004 | 003 | E540 | 0 0 | 00 | 0000
0005 | 004 | E640 | 1 3 | 5A | 0000
0006 | 005 | B0D0 | 0 0 | 00 | 1010
0007 | 006 | D20A | 0 0 | 00 | 1010
0008 | 007 | 1E01 | 1 7 | 01 | 1010
0009 | 008 | EF02 | 0 0 | 00 | 1010
0010 | 009 | F000 | 0 0 | 00 | 1010

golden model, switches = 0x3C

Stalls never appear in the trace
Lines 0004 and 0005 look identical whether SLOW_ECHO waited 0 or 7 cycles. That is the point: the trace checks that waiting changed nothing.

What it proves
IN from a fast port; OUT to LEDs (checked on the board); OUT then IN to the slow port — the stall must not change anything and must produce exactly one line each.

Notes: The I/O test exercises both the fast and the slow path. SLOW_ECHO returns the last byte written after a random delay with io_ready low, so OUT followed by IN on port 0x40 both checks the handshake and makes the OUT observable. The trace is the golden model's output with the switches set to 0x3C. Because a stall is not an architectural event, the trace is the same for any delay: the test passes only if the core waited correctly and committed exactly once. Run it several times with different random delays if your peripheral model allows it.

## Constrained-random programs: let Python write the tests

import random
random.seed(7) # same seed = same program
ops3 = ['ADD', 'SUB', 'AND', 'OR', 'XOR']
lines = [f'LDI R{r}, {random.randrange(256)}' for r in range(8)]
for _ in range(200):
k = random.random()
rd, a, b = (random.randrange(8) for _ in range(3))
if k < 0.6: lines.append(f'{random.choice(ops3)} R{rd}, R{a}, R{b}')
elif k < 0.7: lines.append(f'{random.choice(["SHL","SHR"])} R{rd}, R{a}')
elif k < 0.8: lines.append(f'CMP R{a}, R{b}')
elif k < 0.9: lines.append(f'ST [R{a}], R{b}')
else: lines.append(f'LD R{rd}, [R{a}]')
lines.append('HLT')
open('rand_007.asm', 'w').write('\n'.join(lines) + '\n')

Constrained
no branches and no I/O, so every program terminates and needs no peripheral model

Self-checking for free
assemble it, let dsd8sim.py write gold.trace, diff with dut.trace

Reproducible
the seed is in the file name; a failing seed becomes a permanent regression test

Widen later
add forward-only branches, then bounded loops, once the basics pass

Checked
Seed 7 gives a 209-word program; the golden model retires all 209 instructions and halts.

Notes: Random testing at program level is the processor equivalent of the constrained-random ALU testbench. The generator initialises all eight registers with random constants, then emits 200 random instructions from a safe subset, and ends with HLT. Constraining away branches and I/O guarantees termination and avoids needing peripherals. Because the golden model produces the expected trace, every random program is self-checking. Keep the seed in the file name: when seed 1234 fails, it becomes a directed regression test forever. This exact script, with seed 7, was run through the reference model while preparing this deck.

## Coverage checklist: what 'tested' should mean

Opcodes

all 16, including NOP and HLT

IN and OUT separately

MOV (it is really OR)

Branches

8 conditions × taken / not taken

forward and backward targets

signed compare via N ≠ V

Flags

Z, N, C, V each set and cleared

carry across 0x7F/0x80 and 0xFF/0x00

LD / LDI / IN leave flags alone

Registers

each of R0–R7 as rd, rs1, rs2

aliasing: ADD R1, R1, R1

write then read next instruction

Memory

address 0x00 and 0xFF

never-written read = 0x00

ST then LD, same and different address

PC & I/O

wrap 0x1FF → 0x000

every reserved port; unmapped reads 0x00

SLOW_ECHO stall, OUT then IN

Tick a box only when a test exists, passes, and would fail if that behaviour broke.

Notes: This is a functional-coverage list in checklist form: the behaviours that the specification defines and that a complete set of tests should exercise. It mirrors the conformance groups but goes further, for example by asking for every register in every operand position and for both branch outcomes for all eight conditions. PC wrap needs a program that reaches address 0x1FF; with an assembler that has no origin directive that means padding, which is itself a useful little exercise. The rule at the bottom is the honest definition of tested.

## Bring-up order: prove one path at a time

T05

NOP

fetch, PC, trace

T01

LDI

decode, register write

T23

JMP

branch path into PC

T15–T22

ALU + flags

two operands, flags

T09–T14

LD / ST

memory, ra2 select

T24–T30

Bcc

flags → pc_load

T31–T35

IN / OUT

handshake, stall

T36–T40

programs

everything together

Do not start with ADD
A failing ADD can be the ALU, the decoder, the register file, the write-back mux or the trace. A passing NOP rules out three of those before you write a single ALU line.

Notes: The conformance groups suggest an order of attack, and the starter material recommends it explicitly: NOP first, because it proves fetch, the PC and the trace path; then LDI, which proves register writeback; then JMP, which proves the branch path. After that the ALU, memory, conditional branches and I/O can be brought up in any order, each adding one new path. Teams that begin with ADD typically spend days not knowing whether the bug is in the ALU, the decoder or the trace.

## Take-aways

Frozen ports, free internals. The port lists decide how modules connect; four bits of glue in dsd8_cpu finish the job.

Retire = commit. One pulse per instruction, in the cycle its effects become permanent, with all ten values describing that instruction.

The assembler is two passes and six encoders. Read the listing; the encoder shifts are your decoder's slices.

Tests are evidence. One behaviour each, every result visible, both sides of every decision, expected trace from the golden model.

Debug from the first differing line, not from the waveform.

Lab exercise: write T41–T44 (one per rule in Part 6), run them against your current design, and log the first differing line of each.

Notes: Five sentences to leave with. A suggested lab exercise: each team writes four of its own tests following the six rules, runs them through the golden model and its own design, and records the first differing line for each, with its diagnosis. That record is also the start of the bug log the project requires.
