iraslav/dsd8-TriSync-DSD/(commit log)

2026-10-27 Upload complete DSD-8 project and interrupt add-on
2026-11-03 Add testing report and interrupt test runner
2026-11-03 Fix DSD-8 test runners and ALU example
    [tb_alu_example.v]
